henkjannl/BedClock/README.md

# BedClock
This is a small ESP driven bed clock annex reading light. The device can be controlled using three touch buttons.

<p align="center">
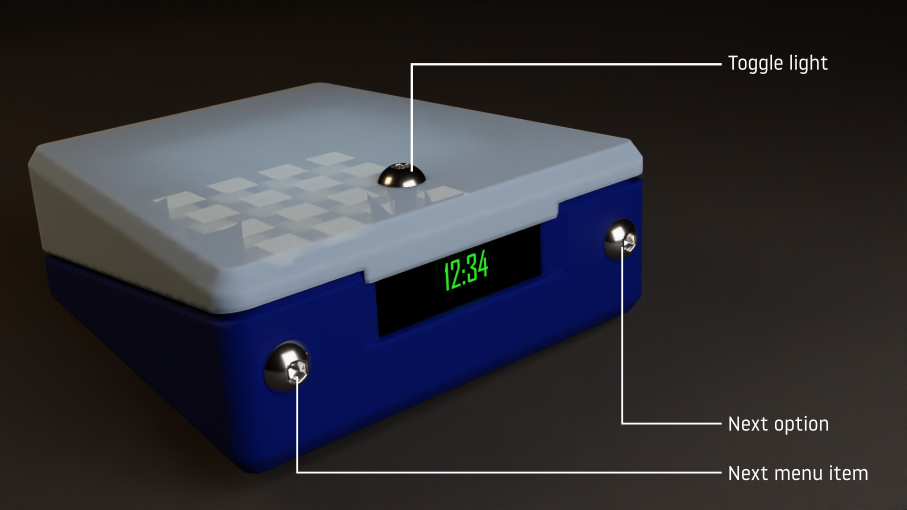
[picture p1: 02 User interface/Blender render/User manual.png]
    
</p>

The top button switches on and off the light on the top of the device. While the light is on, the clock is also shown (since darkness is polluted anyway).

By default the display is empty, because even at the dimmest intensity, the OLED display produces too much light to sleep well.

<p align="center">
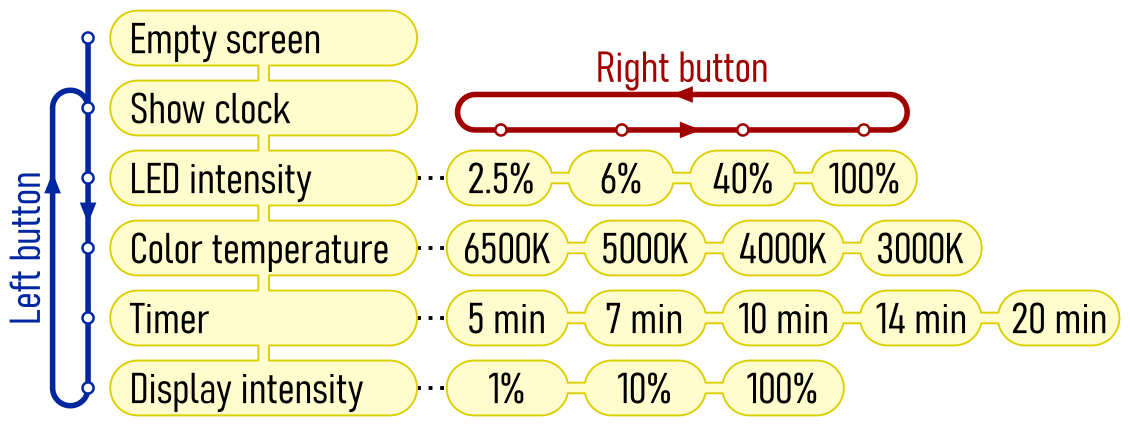
[picture p2: 02 User interface/ESP-IDF application/buttons.png]
    
</p>

The left button is used to wake up the display and browse through the settings. Each setting can be changed with the right button. While changing light settings, the light switches on to immediately show the result.

If the buttons are not touched  for some time, the display switches off again.

Settings are stored in the non volatile storage (NVS) of the ESP32.

## Hardware

This is a list of all items:

| Item | Count | Description | Print time | Price March 2023 |
|:----:|:-----:|---|---|---:|
| 1  | 1 | ESP32 MH-ET Live Minikit | | € 3.63 |
| 2  | 1 | 4x4 Led grid WS2812B | | € 1.00 |
| 3  | 1 | 0.91" OLED 128x32 SSD1306 | | € 1.53 |
| 4  | 1 | Electrical wire AWG 30 | | € 1.68 |
| 5  | 3 | Hexagon head button screw ISO7380-1 M3x8 | | € 1.45 |
| 6  | 3 | Hexagon nut ISO4032 M3 h=2.4 | | € 1.68 |
| 7  | 4 | Self tapping screw M2.3x12 | | € 2.33 |
| 8  | 2 | Self tapping screw M2.3x6 | | € 1.85 |
| 9  | 1 | Bottom part | 1h27 | € 0.50 |
|  10  | 1 | Top part (transparent filament) | 1h14 | € 0.42 |
|  11  | 1 | LED bridge | 0h34 | € 0.14 |
|  12  | 1 | Light cover | 0h05 | € 0.02 |
| | | **Total** | **3h20** | **€ 16.23** |

Items 1..8 were ordered at AliExpress through the following hyperlinks:

| Item | Count | Order |
|:----:|:-----:|---|
| 1  | 1 | https://www.aliexpress.com/item/32858054775.html |
| 2  | 1 | https://www.aliexpress.com/item/32963152993.html |
| 3  | 1 | https://www.aliexpress.com/item/32788923016.html |
| 4  | 1 | https://www.aliexpress.com/item/33030965448.html |
| 5  | 3 | https://www.aliexpress.com/item/32970195293.html |
| 6  | 3 | https://www.aliexpress.com/item/1005003780212966.html |
| 7  | 4 | https://www.aliexpress.com/item/1005003981975435.html |
| 8  | 2 | https://www.aliexpress.com/item/1005003981975435.html |

It can be beneficial to go for an assortment box of stainless steel screws if you have more similar products, like https://www.aliexpress.com/item/1005002526248698.html instead of items 5 and 6. Self tapping screws can also be ordered in assortment boxes.

Items 9..12 were 3D printed. Assumptions for print time and filament cost:
* Printer Prusa Mk3s
* Material PETG
* Layer height 0.2 mm

All devices are connected to the ESP32 by thin wires according to the schematic below:
<br>
<br>

<p align="center">
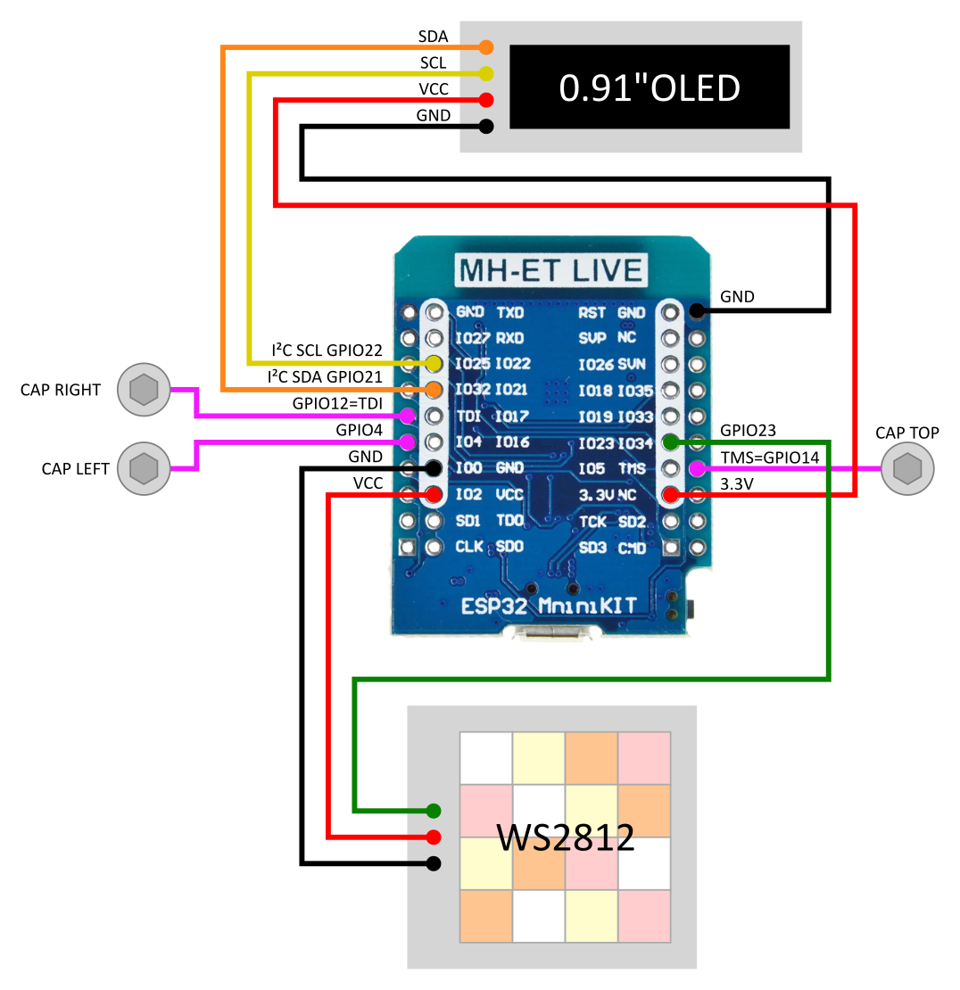
[picture p3: 05 Electrical/Electrical.png]
    
</p>

<br>
<br>

Mechanical assembly is as follows:

<p align="center">
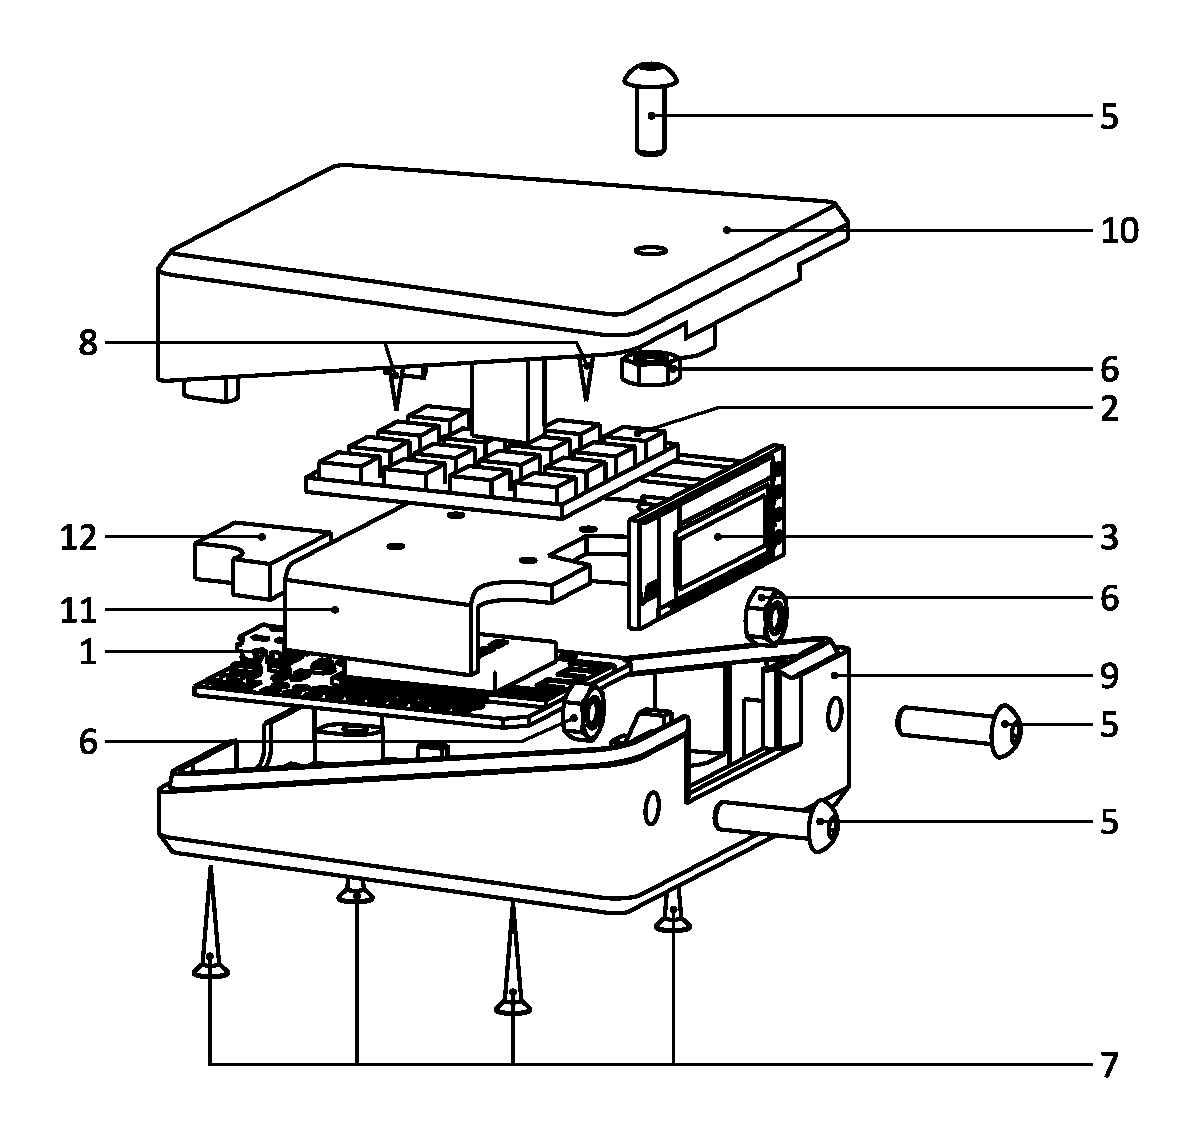
[picture p4: 03 Mechanical/Assembly manual/Assembly manual.png]
    
</p>

The 4x4 LED grid is mounted on top of the LED bridge and then placed over the ESP32.

The light cover 12 is used to cover the onboard LED of the ESP32, since it will shine through the top part if it is not covered.
<br>
<br>

## Software

The original Arduino based software is located in `...\BedClock\04_Software\Bedclock`.

This project was used to learn ESP-IDF programming under PlatformIO. The software projects `BedClock_IDF_V01` until `BedClock_IDF_V12` are demonstrator projects to port parts of the functionality to ESP-IDF.

### Different directories and sub-projects

| Directory | Purpose |
|---|---|
| `Bedclock_IDF_V01` | Test WS2812 led chain |
| `Bedclock_IDF_V02` | Test SSD1306 OLED screen |
| `Bedclock_IDF_V03` | Test capacitive touch sensors |
| `Bedclock_IDF_V04` | Test WiFi |
| `Bedclock_IDF_V05` | Test time sync with timeserver |
| `Bedclock_IDF_V06` | Port timer object using esp_timer_get_time() / 1000; |
| `Bedclock_IDF_V07` | Test FreeRTOS |
| `Bedclock_IDF_V08` | Implement multiple parallel processes |
| `Bedclock_IDF_V09` | Internal Espressif SSD1306 driver including LVGL |
| `Bedclock_IDF_V10` | First working version of application |
| `Bedclock_IDF_V11` | First working version of pixel buffer |
| `Bedclock_IDF_V12` | Latest version of the app with all functionality integrated |

### Files in the `Bedclock_IDF_V12` main directory

| File | Content |
|---|---|
| `main.c` | Main file, includes other files and calls initializers |
| `bl_common.h` | |
| `bl_keyboard.h` | Checks capacitive touch buttons and communicates with display and light |
| `bl_display.h` | Receives signals from keyboard, changes settings and writes current menu state to SSD1306 OLED display  |
| `bl_light.h` | Writes LED info for the LED grid to the rmt encoder |
| `led_strip_encoder.h+c` | Interface to the rmt encoder for the WS2812 LEDs |
| `bl_time.h` | Connection with WiFi, syncing of clock with timeserver |
| `config.h` | Private user data such as router name and password and timezone (not submitted to Github) |
| `hp_pixel_buffer.h+c` | Library that defines a bitmap for display on the OLED display |
| `hp_pixel_canvas.h+c` | Library that allows writing bitmaps to a buffer, and streaming the buffer to the SSD1306 OLED display |
| `fonts\...` | Font definitions |
| `hp_stepping_float.h` | Library that plans and executes paths in linear and non-linear ways (see also `hp_stepping_interpolation_t` below). |
| `hp_timer.h` | Library that defines a repeating or single-shot timer with microsecond resolution. |

The `config.h` file requires three `#defines`:
```c
#define WIFI_SSID    "xxxxxxxxx"                     // Name of the WiFi router
#define WIFI_PASS    "yyyyyyyy"                      // Password for the WiFi router
#define TIME_ZONE    "CET-1CEST,M3.5.0,M10.5.0/3"    // Timezone code
```

The last code is the timezone definition of Amsterdam. Codes for other locations can be found in https://github.com/nayarsystems/posix_tz_db/blob/master/zones.csv

In `hp_stepping_float.h`, the `hp_stepping_interpolation_t` type is an enumerator that defines the move path between origin and target in the following way:

<p align="center">
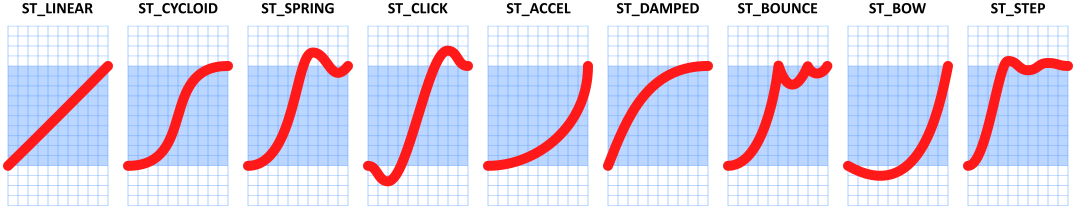
[picture p5: 01 System/Move profiles/Move.png]
    
</p>

### Issues

#### SSD1306
The OLED display sometimes freezes due to some unknown error. Since the hardware reset pin is not provided as GPIO for this display, only software reset is left as an option.

The clock frequency of I2C communication was reduced from 400kHz to 370kHz, since, according to the Salomon specification of the SSD1306, a frequency of up to 407kHz is tolerated, so there is not much headroom at 400kHz. This has not been an adequate solution. I'm not sure if 370kHz is actually working on the ESP32, or if it is rounded up to 400kHz as well.

As a fallback, pressing the left and right button at the same time resets the device. This is currently being tested.

See also:
https://iotexpert.com/debugging-ssd1306-display-problems/

Then the charge pump may be off
```c
    //////// Charge pump regulator
    OLED_CHARGEPUMP,          // 0x8D Set charge pump
    0x14,                     // VCC generated by internal DC/DC circuit
```
or maybe the screen is off… try turning it on.
```c
    OLED_DISPLAYON,           // 0xAF  //Set display on
```
or maybe you haven’t displayed anything. The screen is off trying sending a screen invert
```c
    #define OLED_DISPLAYINVERT                            0xA7
```

#### Filtering of capacitive touch buttons
The filtering of the capacitive touch buttons does not seem to work well, so I am using the unfiltered signal. Since there are sometimes 1 sample spikes on this signal, a button press is  only acknowledged if there are 3 subsequent samples below the threshold value.

If filtering works, it could also be a good idea to tie the capacitive touch buttons to an interrupt to relieve processor load.
