henkjannl/BedClock/04_Software/readme.md

### Readme
`Bedclock` is the software for the Arduino environment.

Different projects were created to port the Arduino version to ESP-IDF:
  * `Bedclock_IDF_V01` : Test WS2812 led chain
  * `Bedclock_IDF_V02` : Test SSD1306 OLED screen
  * `Bedclock_IDF_V03` : Test capacitive touch sensors
  * `Bedclock_IDF_V04` : Test WiFi
  * `Bedclock_IDF_V05` : Test time sync with timeserver
  * `Bedclock_IDF_V06` : Port timer object using esp_timer_get_time() / 1000;
  * `Bedclock_IDF_V07` : Test FreeRTOS
  * `Bedclock_IDF_V08` : Implement multiple parallel processes
  * `Bedclock_IDF_V09` : Internal Espressif SSD1306 driver including LVGL
  * `Bedclock_IDF_V10` : First working version of application
  * `Bedclock_IDF_V11` : First working version of pixel buffer
  * `Bedclock_IDF_V12` : First working version with graphics layout

`Bedclock_IDF_V12` is the version currently working.
