henkjannl/BedClock/01 System/Reorganize architecture (work in progress).ods

 |  |  | Row properties | Item properties:
 |  |  | Yoffset (32=hidden) | Label
 |  |  | Xoffset | Xoffset in row
 |  |  | Map of Items | Width
 |  |  | SelectedItem | Command when select is pressed
 |  |  |  | Command when next is pressed
 |  |  | Rows: | Items:
 |  |  | rwMain | itTimer, itBrightness, itColor, itGoBack
 |  |  | rwTimer | itTimer3min, itTimer5min, itTimer10min, itTimer20min
 |  |  | rwBrightness | itBrightness10, itBrightness20, itBrightness50, itBrightness100
 |  |  | rwColor | itColorWhite, itColorYellow, itColorOrange, itColorRed
 |  |  | General structure
 |  |  | Mode: | mdClock, mdSingleRow, mdDoubleRow
 |  |  | Map of rows
 |  |  | Top row
 |  |  | Bottom row
selected item | select button | next button
cmdClock | Display first row at bottom of screen Select cmdTimer | display first row at bottom of screen Timer selected
cmdTimer | Shift up screen to display second row Display timer options in second row Current interval selected | Select cmdBrightness
cmdBrightness | Shift up screen to display second row Display brightness options Current brightness selected | Select cmdColor
cmdColor | Shift up screen to display second row Display color options in second row Current option selected | Select cmdGoBack
cmdGoBack | Display clock | Select cmdTimer
cmdTimer3min | Set timer interval of 3 minutes Display first row at bottom of screen Select cmdTimer | Select cmdTimer5min
cmdTimer5min | Set timer interval of 5 minutes Display first row at bottom of screen Select cmdTimer | Select cmdTimer10min
cmdTimer10min | Set timer interval of 10 minutes Display first row at bottom of screen Select cmdTimer | Select cmdTimer20min
cmdTimer20min | Set timer interval of 20 minutes Display first row at bottom of screen Select cmdTimer | Select cmdTimer3min
