henkjannl/BedClock/04_Software/Bedclock_IDF_V03/readme.txt

### Readme
Bedclock_IDF_V01 demonstrates WS2812 LEDs
Bedclock_IDF_V02 demonstrates the display
Bedclock_IDF_V03 demonstrates capacitive touch buttons
Bedclock_IDF_V03 demonstrates  WiFi
