henkjannl/BedClock/04_Software/Bedclock_IDF_V01/readme.txt

### Readme
This project shows that the WS2812 LEDs are working
