henkjannl/BedClock/04_Software/Bedclock_IDF_V02/readme.txt

### Readme
Bedclock_IDF_V01 shows that the WS2812 LEDs are working
Bedclock_IDF_V02 shows the display is working
