henkjannl/BedClock/02 User interface/Blender render/Bedlight.png

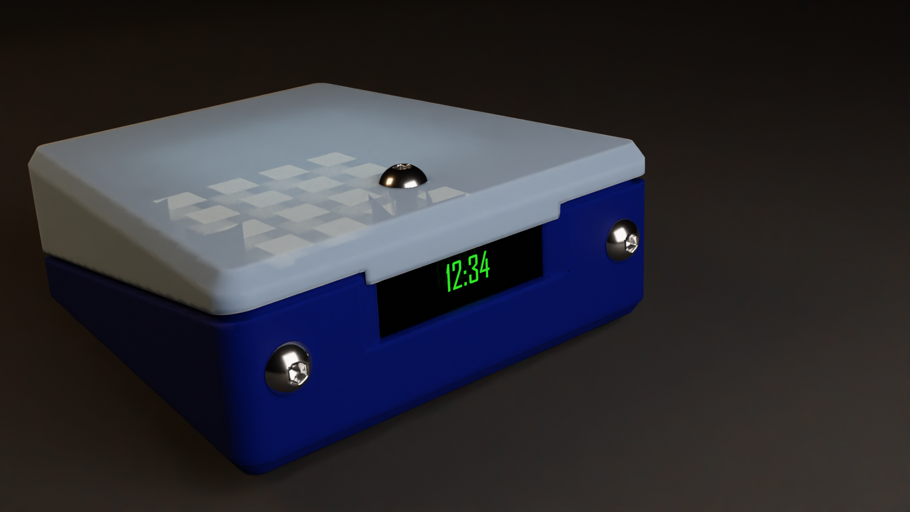
02 User interface/Blender render/Bedlight.png
