henkjannl/BedClock/02 User interface/Blender render/Telegram keyboard.png

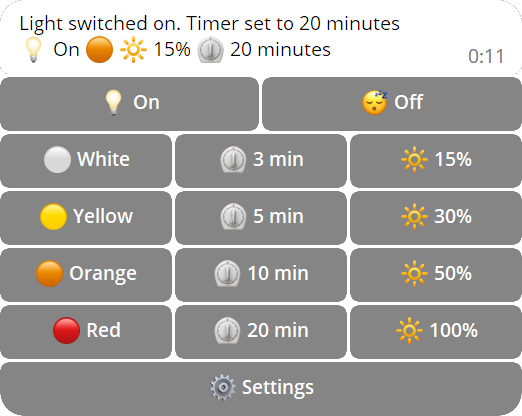
02 User interface/Blender render/Telegram keyboard.png
