henkjannl/BedClock/02 User interface/ESP-IDF application/128x32 GUI V5.png

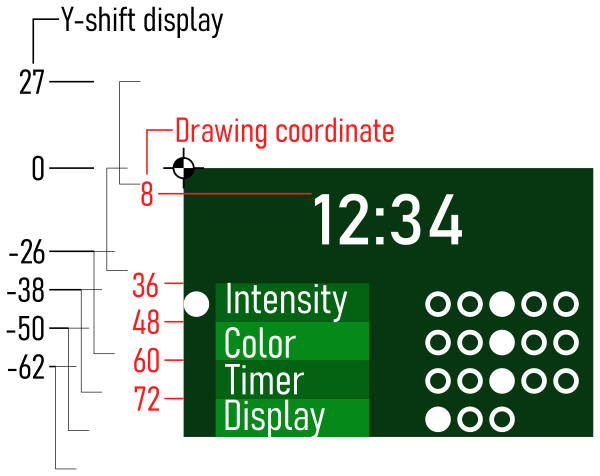
02 User interface/ESP-IDF application/128x32 GUI V5.png
