henkjannl/BedClock/02 User interface/HTML button tag_files/160x600_starterkit0.png

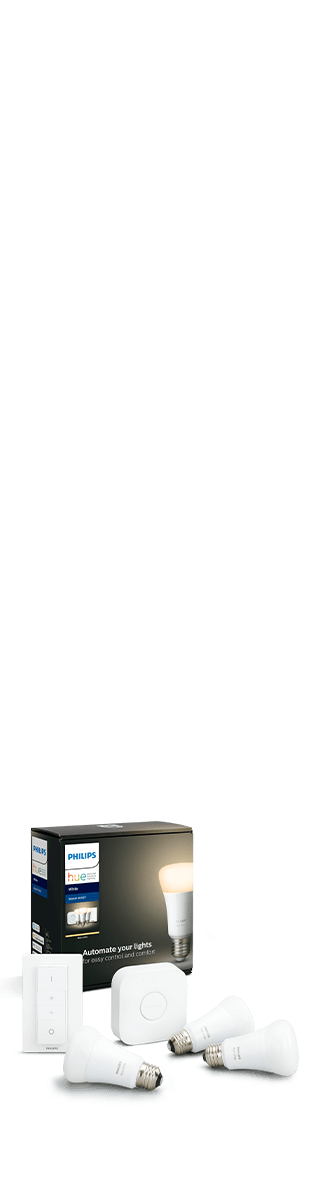
02 User interface/HTML button tag_files/160x600_starterkit0.png
