henkjannl/BedClock/02 User interface/HTML button tag_files/160x600_starterkit2.png

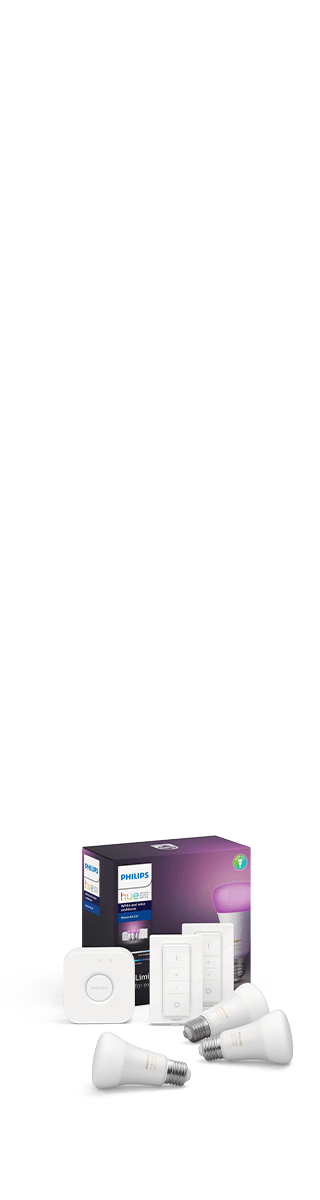
02 User interface/HTML button tag_files/160x600_starterkit2.png
