henkjannl/BedClock/02 User interface/HTML button tag_files/300x250_starterkit0.png

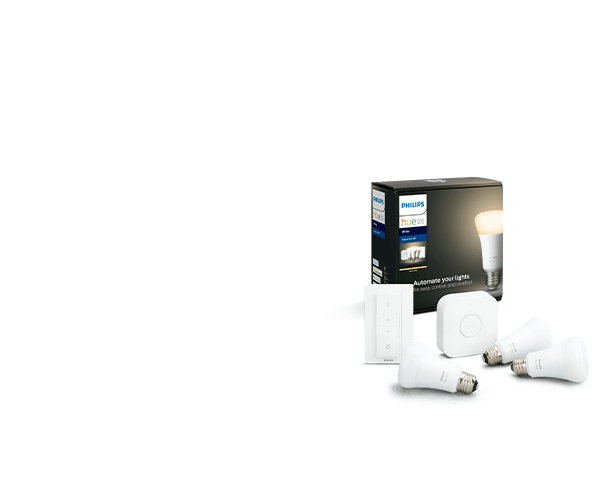
02 User interface/HTML button tag_files/300x250_starterkit0.png
