henkjannl/BedClock/02 User interface/HTML button tag_files/hue(1).png

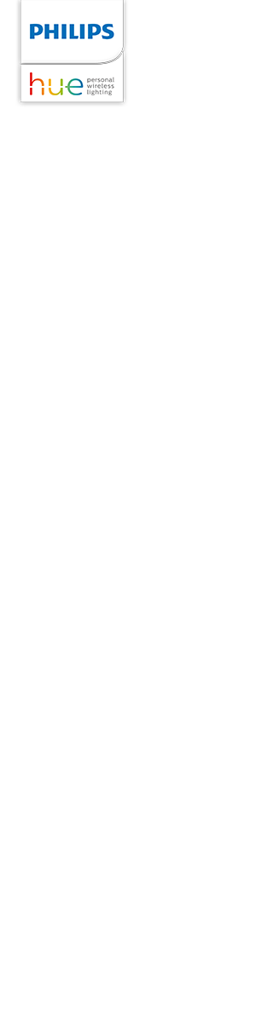
02 User interface/HTML button tag_files/hue(1).png
