henkjannl/BedClock/02 User interface/HTML button tag_files/hue.png

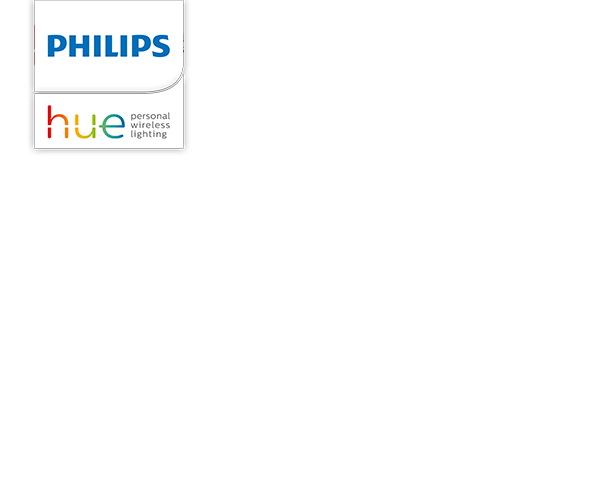
02 User interface/HTML button tag_files/hue.png
