henkjannl/BedClock/03 Mechanical/LEDs.stl

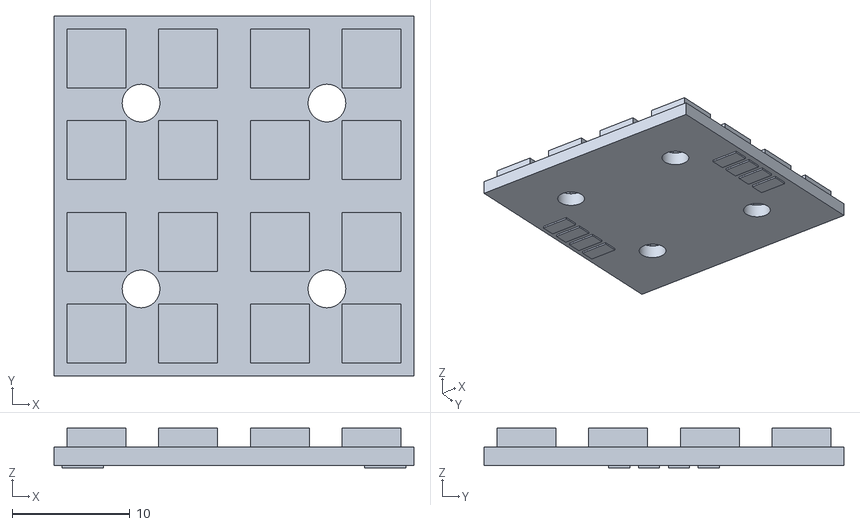
[picture p15: CAD file, 2023-03-12]
03 Mechanical/LEDs.stl
30.6 x 30.6 x 3.40
