henkjannl/BedClock/03 Mechanical/V2/Bridge.stl

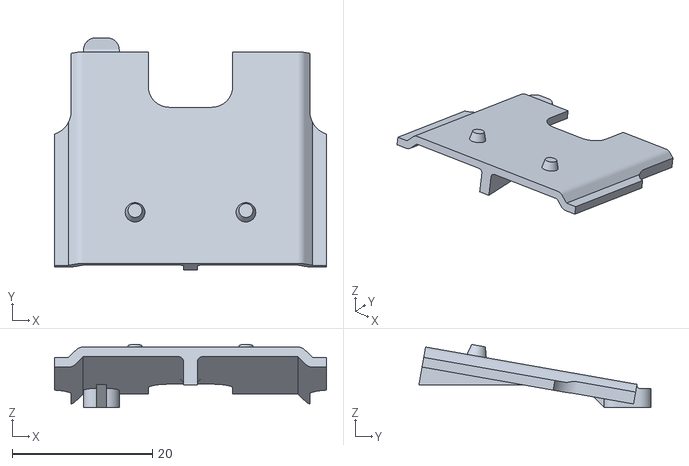
[picture p16: CAD file, 2023-03-17]
03 Mechanical/V2/Bridge.stl
38.8 x 33.1 x 9.00
