henkjannl/BedClock/03 Mechanical/Display 0.91'' 128x32 ST1306.FCStd

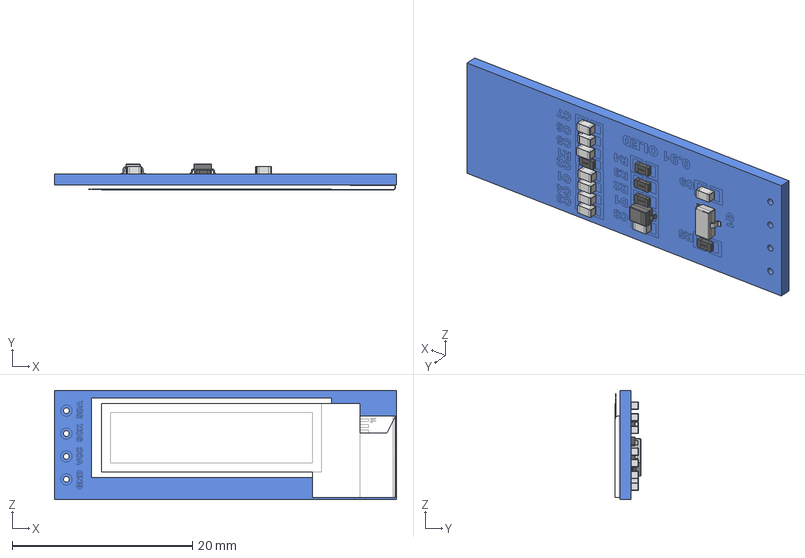
[picture p17: CAD file, 2023-03-12]
03 Mechanical/Display 0.91'' 128x32 ST1306.FCStd
37.9 x 2.93 x 12.1 mm
0.91in oled Module - Board
0.91in OLED - Folded Flush - Without Glass
0603 Capacitor
0603 Capacitor001
0603 Capacitor002
0603 Capacitor003
0603 Capacitor004
0603 Capacitor005
0603 Capacitor006
0603 Capacitor007
0603 Capacitor008
0603 Resistor
0603 Resistor001
0603 Resistor002
0603 Resistor003
0603 Resistor004
SOT23-3
Diode (SOD-323)
