henkjannl/BedClock/03 Mechanical/V2/Bottom housing V2.stl

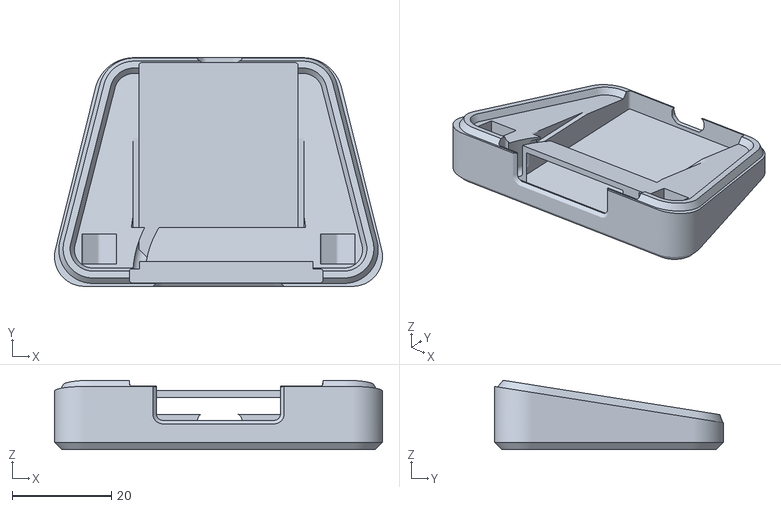
[picture p18: CAD file, 2023-03-12]
03 Mechanical/V2/Bottom housing V2.stl
66.0 x 46.0 x 14.0
