henkjannl/BedClock/03 Mechanical/Table.stl

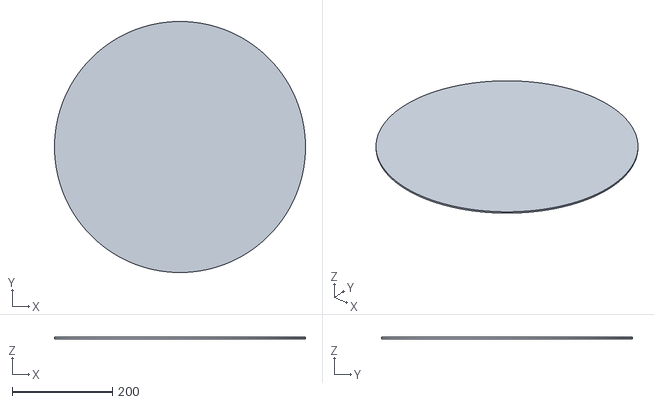
[picture p19: CAD file, 2023-03-12]
03 Mechanical/Table.stl
500.0 x 500.0 x 3.00
