henkjannl/BedClock/03 Mechanical/Bridge.stl

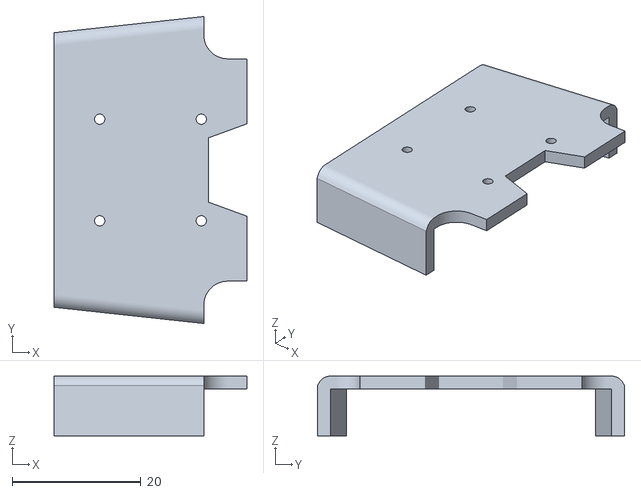
[picture p20: CAD file, 2023-03-12]
03 Mechanical/Bridge.stl
30.0 x 47.7 x 9.30
