henkjannl/BedClock/03 Mechanical/NightLight rotary.FCStd

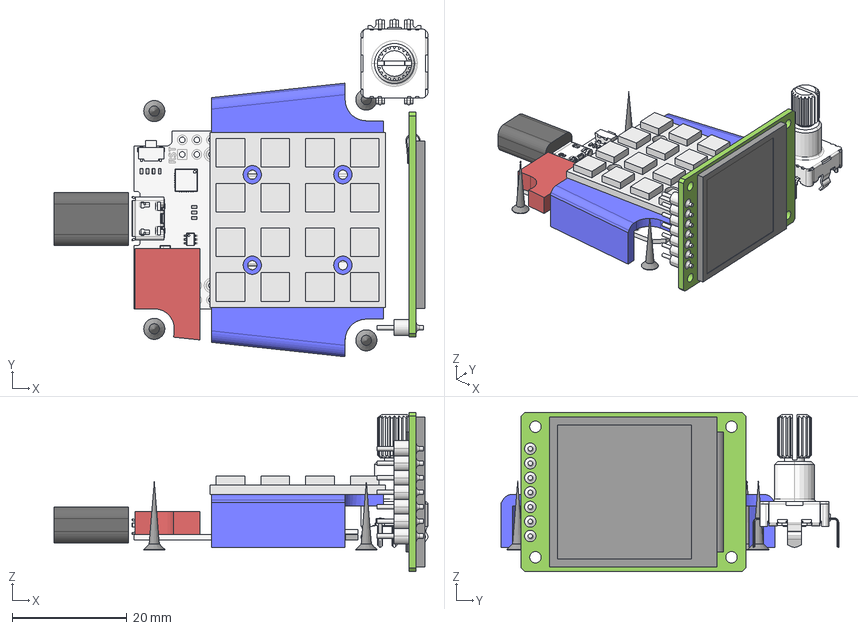
[picture p21: CAD file, 2023-01-20]
03 Mechanical/NightLight rotary.FCStd
65.3 x 58.9 x 27.8 mm
MH-ET_LIVE_MiniKit
USB connector
SelftappingScrew 2.3x12 - Bottom1
SelftappingScrew 2.3x12 - Bottom2
SelftappingScrew 2.3x12 - Bottom3
SelftappingScrew 2.3x12 - Bottom4
Bridge
LightCover
WS2812B 4x4_001
EC11E-05SW
SCREEN
GLASS
FIRSTPIN
