henkjannl/BedClock/03 Mechanical/Bottom.stl

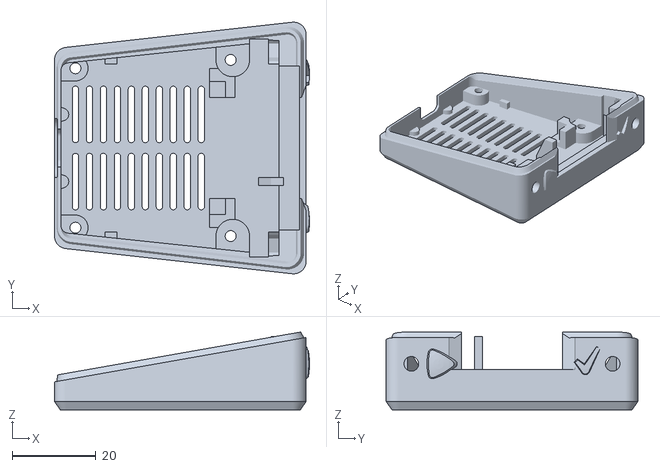
[picture p22: CAD file, 2021-05-28]
03 Mechanical/Bottom.stl
60.8 x 60.0 x 18.6
