henkjannl/BedClock/03 Mechanical/Top.stl

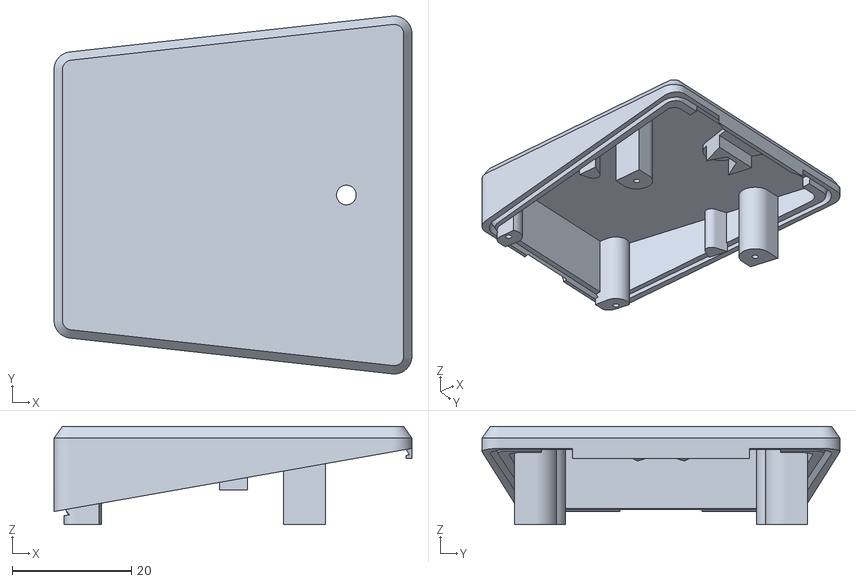
[picture p23: CAD file, 2021-04-11]
03 Mechanical/Top.stl
60.0 x 60.0 x 16.5
