henkjannl/BedClock/03 Mechanical/esp32-mh-et-live-minikit-d1.FCStd

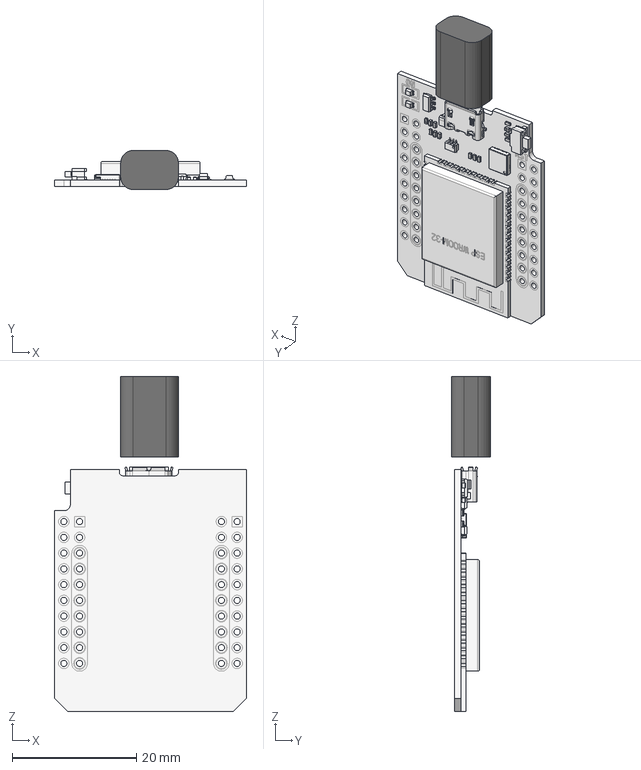
[picture p24: CAD file, 2021-04-11]
03 Mechanical/esp32-mh-et-live-minikit-d1.FCStd
31.0 x 6.30 x 54.0 mm
MH-ET_LIVE_MiniKit
