henkjannl/BedClock/03 Mechanical/Lightcover.stl

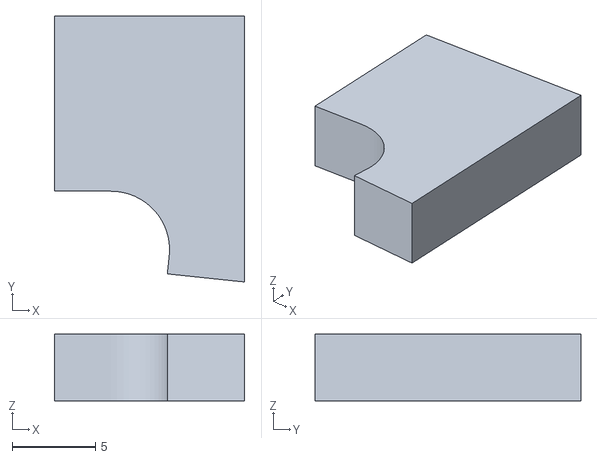
[picture p25: CAD file, 2021-04-11]
03 Mechanical/Lightcover.stl
11.4 x 15.9 x 4.00
