henkjannl/BedClock/03 Mechanical/SelftappingScrewM2.3x12.FCStd

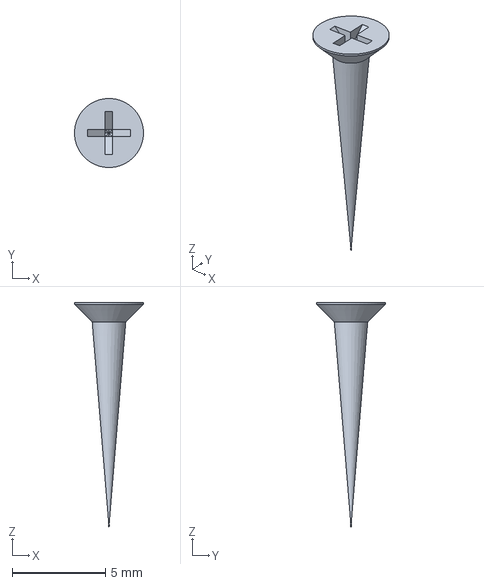
[picture p26: CAD file, 2021-04-11]
03 Mechanical/SelftappingScrewM2.3x12.FCStd
3.70 x 3.70 x 12.0 mm
