henkjannl/BedClock/(list of files, cad)

Other CAD files:
03 Mechanical/WS2812B 4x4.FCStd
