henkjannl/BedClock/04_Software/_Feasibility/03 DimSmooth/Brightness steps.xlsx

Order to switch on |  |  |  |  | Brightness substep | Additional LED | Decimal | Binary | Const
 | 0 | 1 | 2 | 3 | 0 |  | 0 | 0000000000000000 | 0x0000,
0 | 14 | 0 | 4 | 8 | 1 | 1 | 2 | 0000000000000010 | 0x0000, 0x0002,
4 | 7 | 11 | 13 | 1 | 2 | 7 | 130 | 0000000010000010 | 0x0000, 0x0002, 0x0082,
8 | 3 | 9 | 15 | 5 | 3 | 14 | 16514 | 0100000010000010 | 0x0000, 0x0002, 0x0082, 0x4082,
12 | 12 | 6 | 2 | 10 | 4 | 8 | 16770 | 0100000110000010 | 0x0000, 0x0002, 0x0082, 0x4082, 0x4182,
 |  |  |  |  | 5 | 2 | 16774 | 0100000110000110 | 0x0000, 0x0002, 0x0082, 0x4082, 0x4182, 0x4186,
 |  |  |  |  | 6 | 11 | 18822 | 0100100110000110 | 0x0000, 0x0002, 0x0082, 0x4082, 0x4182, 0x4186, 0x4986,
 |  |  |  |  | 7 | 13 | 27014 | 0110100110000110 | 0x0000, 0x0002, 0x0082, 0x4082, 0x4182, 0x4186, 0x4986, 0x6986,
 |  |  |  |  | 8 | 4 | 27030 | 0110100110010110 | 0x0000, 0x0002, 0x0082, 0x4082, 0x4182, 0x4186, 0x4986, 0x6986, 0x6996,
 |  |  |  |  | 9 | 3 | 27038 | 0110100110011110 | 0x0000, 0x0002, 0x0082, 0x4082, 0x4182, 0x4186, 0x4986, 0x6986, 0x6996, 0x699E,
 |  |  |  |  | 10 | 9 | 27550 | 0110101110011110 | 0x0000, 0x0002, 0x0082, 0x4082, 0x4182, 0x4186, 0x4986, 0x6986, 0x6996, 0x699E, 0x6B9E,
 |  |  |  |  | 11 | 15 | 60318 | 1110101110011110 | 0x0000, 0x0002, 0x0082, 0x4082, 0x4182, 0x4186, 0x4986, 0x6986, 0x6996, 0x699E, 0x6B9E, 0xEB9E,
 |  |  |  |  | 12 | 5 | 60350 | 1110101110111110 | 0x0000, 0x0002, 0x0082, 0x4082, 0x4182, 0x4186, 0x4986, 0x6986, 0x6996, 0x699E, 0x6B9E, 0xEB9E, 0xEBBE,
 |  |  |  |  | 13 | 12 | 64446 | 1111101110111110 | 0x0000, 0x0002, 0x0082, 0x4082, 0x4182, 0x4186, 0x4986, 0x6986, 0x6996, 0x699E, 0x6B9E, 0xEB9E, 0xEBBE, 0xFBBE,
 |  |  |  |  | 14 | 6 | 64510 | 1111101111111110 | 0x0000, 0x0002, 0x0082, 0x4082, 0x4182, 0x4186, 0x4986, 0x6986, 0x6996, 0x699E, 0x6B9E, 0xEB9E, 0xEBBE, 0xFBBE, 0xFBFE,
 |  |  |  |  | 15 | 0 | 64511 | 1111101111111111 | 0x0000, 0x0002, 0x0082, 0x4082, 0x4182, 0x4186, 0x4986, 0x6986, 0x6996, 0x699E, 0x6B9E, 0xEB9E, 0xEBBE, 0xFBBE, 0xFBFE, 0xFBFF,
The last LED will be switched on at the next major brightness step |  |  |  |  |  | 10 | 65535 | 1111111111111111
