henkjannl/BedClock/02 User interface/ESP-IDF application/user manual.png

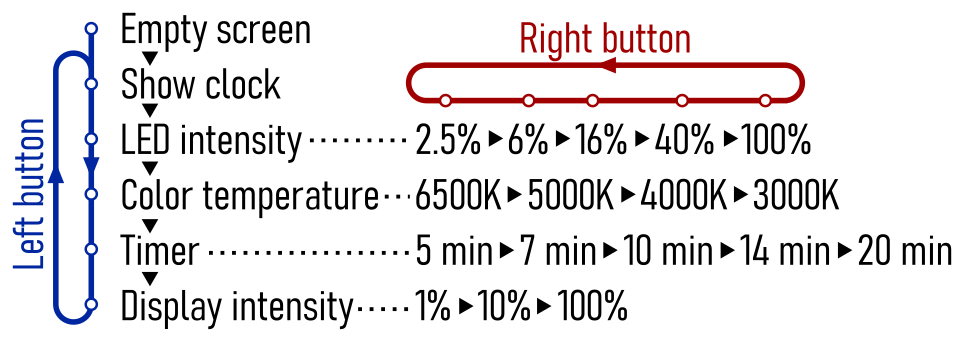
02 User interface/ESP-IDF application/user manual.png
