henkjannl/BedClock/01 System/Debounce capacitive sensors/Result from median kernel 3.txt

80	80
80	80
80	80
80	80
80	80
80	80
80	80
79	80
80	80
80	80
80	80
80	80
80	80
80	80
80	80
80	80
80	80
80	79
80	79
80	79
80	79
80	80
80	80
80	80
80	80
80	80
80	79
80	79
80	79
80	80
80	80
80	80
79	80
80	80
80	79
80	79
80	79
80	80
80	80
80	80
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
