henkjannl/BedClock/02 User interface/Arduino application/Full U8G2 font list/GetFontHeightAndWidth/GetFontHeightAndWidth.ino

#include <Wire.h>
#include <U8g2lib.h>

U8G2_SSD1306_128X32_UNIVISION_F_SW_I2C u8g2(U8G2_R2, 22, 21, U8X8_PIN_NONE);  

void setup() {
  Serial.begin(115200);
  u8g2.initDisplay();
  delay(500);
  u8g2.begin();
  TestAllFonts();
}

void loop() {
  // put your main code here, to run repeatedly:

}


struct font_t {
  char fontName[50];
  const uint8_t *font;
};

const font_t TF_FONTS[] = {
/*     
  { "u8g2_font_u8glib_4_tf", u8g2_font_u8glib_4_tf },
  { "u8g2_font_m2icon_5_tf", u8g2_font_m2icon_5_tf },
  { "u8g2_font_m2icon_7_tf", u8g2_font_m2icon_7_tf },
  { "u8g2_font_m2icon_9_tf", u8g2_font_m2icon_9_tf },
  { "u8g2_font_cursor_tf", u8g2_font_cursor_tf },    
  { "u8g2_font_4x6_tf", u8g2_font_4x6_tf },
  { "u8g2_font_5x7_tf", u8g2_font_5x7_tf },
  { "u8g2_font_5x8_tf", u8g2_font_5x8_tf },
  { "u8g2_font_6x10_tf", u8g2_font_6x10_tf },
  { "u8g2_font_6x12_tf", u8g2_font_6x12_tf },
  { "u8g2_font_6x13_tf", u8g2_font_6x13_tf },
  { "u8g2_font_6x13B_tf", u8g2_font_6x13B_tf },
  { "u8g2_font_6x13O_tf", u8g2_font_6x13O_tf },
  { "u8g2_font_7x13_tf", u8g2_font_7x13_tf },
  { "u8g2_font_7x13B_tf", u8g2_font_7x13B_tf },
  { "u8g2_font_7x13O_tf", u8g2_font_7x13O_tf },
  { "u8g2_font_7x14_tf", u8g2_font_7x14_tf },
  { "u8g2_font_7x14B_tf", u8g2_font_7x14B_tf },
  { "u8g2_font_8x13_tf", u8g2_font_8x13_tf },
  { "u8g2_font_8x13B_tf", u8g2_font_8x13B_tf },
  { "u8g2_font_8x13O_tf", u8g2_font_8x13O_tf },
  { "u8g2_font_9x15_tf", u8g2_font_9x15_tf },
  { "u8g2_font_9x15B_tf", u8g2_font_9x15B_tf },
  { "u8g2_font_9x18_tf", u8g2_font_9x18_tf },
  { "u8g2_font_9x18B_tf", u8g2_font_9x18B_tf },
  { "u8g2_font_10x20_tf", u8g2_font_10x20_tf },
  { "u8g2_font_tom_thumb_4x6_tf", u8g2_font_tom_thumb_4x6_tf },
  { "u8g2_font_mystery_quest_24_tf", u8g2_font_mystery_quest_24_tf },
  { "u8g2_font_mystery_quest_28_tf", u8g2_font_mystery_quest_28_tf },
  { "u8g2_font_t0_11_tf", u8g2_font_t0_11_tf },
  { "u8g2_font_t0_11b_tf", u8g2_font_t0_11b_tf },
  { "u8g2_font_t0_12_tf", u8g2_font_t0_12_tf },
  { "u8g2_font_t0_12b_tf", u8g2_font_t0_12b_tf },
  { "u8g2_font_t0_13_tf", u8g2_font_t0_13_tf },
  { "u8g2_font_t0_13b_tf", u8g2_font_t0_13b_tf },
  { "u8g2_font_t0_14_tf", u8g2_font_t0_14_tf },
  { "u8g2_font_t0_14b_tf", u8g2_font_t0_14b_tf },
  { "u8g2_font_t0_15_tf", u8g2_font_t0_15_tf },
  { "u8g2_font_t0_15b_tf", u8g2_font_t0_15b_tf },
  { "u8g2_font_t0_16_tf", u8g2_font_t0_16_tf },
  { "u8g2_font_t0_16b_tf", u8g2_font_t0_16b_tf },
  { "u8g2_font_t0_17_tf", u8g2_font_t0_17_tf },
  { "u8g2_font_t0_17b_tf", u8g2_font_t0_17b_tf },
  { "u8g2_font_t0_18_tf", u8g2_font_t0_18_tf },
  { "u8g2_font_t0_18b_tf", u8g2_font_t0_18b_tf },
  { "u8g2_font_t0_22_tf", u8g2_font_t0_22_tf },
  { "u8g2_font_t0_22b_tf", u8g2_font_t0_22b_tf },
  { "u8g2_font_profont10_tf", u8g2_font_profont10_tf },
  { "u8g2_font_profont11_tf", u8g2_font_profont11_tf },
  { "u8g2_font_profont12_tf", u8g2_font_profont12_tf },
  { "u8g2_font_profont15_tf", u8g2_font_profont15_tf },
  { "u8g2_font_profont17_tf", u8g2_font_profont17_tf },
  { "u8g2_font_profont22_tf", u8g2_font_profont22_tf },
  { "u8g2_font_profont29_tf", u8g2_font_profont29_tf },
  { "u8g2_font_mozart_nbp_tf", u8g2_font_mozart_nbp_tf },
  { "u8g2_font_glasstown_nbp_tf", u8g2_font_glasstown_nbp_tf },
  { "u8g2_font_shylock_nbp_tf", u8g2_font_shylock_nbp_tf },
  { "u8g2_font_roentgen_nbp_tf", u8g2_font_roentgen_nbp_tf },
  { "u8g2_font_calibration_gothic_nbp_tf", u8g2_font_calibration_gothic_nbp_tf },
  { "u8g2_font_smart_patrol_nbp_tf", u8g2_font_smart_patrol_nbp_tf },
  { "u8g2_font_prospero_bold_nbp_tf", u8g2_font_prospero_bold_nbp_tf },
  { "u8g2_font_prospero_nbp_tf", u8g2_font_prospero_nbp_tf },
  { "u8g2_font_balthasar_regular_nbp_tf", u8g2_font_balthasar_regular_nbp_tf },
  { "u8g2_font_balthasar_titling_nbp_tf", u8g2_font_balthasar_titling_nbp_tf },
  { "u8g2_font_synchronizer_nbp_tf", u8g2_font_synchronizer_nbp_tf },
  { "u8g2_font_mercutio_basic_nbp_tf", u8g2_font_mercutio_basic_nbp_tf },
  { "u8g2_font_mercutio_sc_nbp_tf", u8g2_font_mercutio_sc_nbp_tf },
  { "u8g2_font_miranda_nbp_tf", u8g2_font_miranda_nbp_tf },
  { "u8g2_font_nine_by_five_nbp_tf", u8g2_font_nine_by_five_nbp_tf },
  { "u8g2_font_rosencrantz_nbp_tf", u8g2_font_rosencrantz_nbp_tf },
  { "u8g2_font_guildenstern_nbp_tf", u8g2_font_guildenstern_nbp_tf },
  { "u8g2_font_astragal_nbp_tf", u8g2_font_astragal_nbp_tf },
  { "u8g2_font_habsburgchancery_tf", u8g2_font_habsburgchancery_tf },
  { "u8g2_font_missingplanet_tf", u8g2_font_missingplanet_tf },
  { "u8g2_font_ordinarybasis_tf", u8g2_font_ordinarybasis_tf },
  { "u8g2_font_pixelmordred_tf", u8g2_font_pixelmordred_tf },
  { "u8g2_font_secretaryhand_tf", u8g2_font_secretaryhand_tf },
  { "u8g2_font_garbagecan_tf", u8g2_font_garbagecan_tf },
  { "u8g2_font_oldwizard_tf", u8g2_font_oldwizard_tf },
  { "u8g2_font_bitcasual_tf", u8g2_font_bitcasual_tf },
  { "u8g2_font_koleeko_tf", u8g2_font_koleeko_tf },
  { "u8g2_font_tenfatguys_tf", u8g2_font_tenfatguys_tf },
  { "u8g2_font_tenthinguys_tf", u8g2_font_tenthinguys_tf },
  { "u8g2_font_tenthinnerguys_tf", u8g2_font_tenthinnerguys_tf },
  { "u8g2_font_fewture_tf", u8g2_font_fewture_tf },
  { "u8g2_font_halftone_tf", u8g2_font_halftone_tf },
  { "u8g2_font_nerhoe_tf", u8g2_font_nerhoe_tf },
  { "u8g2_font_oskool_tf", u8g2_font_oskool_tf },
  { "u8g2_font_tinytim_tf", u8g2_font_tinytim_tf },
  { "u8g2_font_tooseornament_tf", u8g2_font_tooseornament_tf },
  { "u8g2_font_finderskeepers_tf", u8g2_font_finderskeepers_tf },
  { "u8g2_font_adventurer_tf", u8g2_font_adventurer_tf },
  { "u8g2_font_frikativ_tf", u8g2_font_frikativ_tf },
  { "u8g2_font_fancypixels_tf", u8g2_font_fancypixels_tf },
  { "u8g2_font_fourmat_tf", u8g2_font_fourmat_tf },
  { "u8g2_font_smolfont_tf", u8g2_font_smolfont_tf },
  { "u8g2_font_tinyunicode_tf", u8g2_font_tinyunicode_tf },
  { "u8g2_font_micropixel_tf", u8g2_font_micropixel_tf },
  { "u8g2_font_simple1_tf", u8g2_font_simple1_tf },
  { "u8g2_font_scrum_tf", u8g2_font_scrum_tf },
  { "u8g2_font_8bitclassic_tf", u8g2_font_8bitclassic_tf },
  { "u8g2_font_new3x9pixelfont_tf", u8g2_font_new3x9pixelfont_tf },
  { "u8g2_font_bytesize_tf", u8g2_font_bytesize_tf },
  { "u8g2_font_pixzillav1_tf", u8g2_font_pixzillav1_tf },
  { "u8g2_font_pxclassic_tf", u8g2_font_pxclassic_tf },
  { "u8g2_font_tallpixelextended_tf", u8g2_font_tallpixelextended_tf },
  { "u8g2_font_BBSesque_tf", u8g2_font_BBSesque_tf },
  { "u8g2_font_Born2bSportySlab_tf", u8g2_font_Born2bSportySlab_tf },
  { "u8g2_font_Born2bSportyV2_tf", u8g2_font_Born2bSportyV2_tf },
  { "u8g2_font_Engrish_tf", u8g2_font_Engrish_tf },
  { "u8g2_font_IPAandRUSLCD_tf", u8g2_font_IPAandRUSLCD_tf },
  { "u8g2_font_Georgia7px_tf", u8g2_font_Georgia7px_tf },
  { "u8g2_font_NokiaLargeBold_tf", u8g2_font_NokiaLargeBold_tf },
  { "u8g2_font_NokiaSmallBold_tf", u8g2_font_NokiaSmallBold_tf },
  { "u8g2_font_NokiaSmallPlain_tf", u8g2_font_NokiaSmallPlain_tf },
  { "u8g2_font_12x6LED_tf", u8g2_font_12x6LED_tf },
  { "u8g2_font_9x6LED_tf", u8g2_font_9x6LED_tf },
  { "u8g2_font_nokiafc22_tf", u8g2_font_nokiafc22_tf },
  { "u8g2_font_VCR_OSD_tf", u8g2_font_VCR_OSD_tf },
  { "u8g2_font_Pixellari_tf", u8g2_font_Pixellari_tf },
  { "u8g2_font_DigitalDiscoThin_tf", u8g2_font_DigitalDiscoThin_tf },
  { "u8g2_font_DigitalDisco_tf", u8g2_font_DigitalDisco_tf },
  { "u8g2_font_crox1cb_tf", u8g2_font_crox1cb_tf },
  { "u8g2_font_crox1c_tf", u8g2_font_crox1c_tf },
  { "u8g2_font_crox1hb_tf", u8g2_font_crox1hb_tf },
  { "u8g2_font_crox1h_tf", u8g2_font_crox1h_tf },
  { "u8g2_font_crox1tb_tf", u8g2_font_crox1tb_tf },
  { "u8g2_font_crox1t_tf", u8g2_font_crox1t_tf },
  { "u8g2_font_crox2cb_tf", u8g2_font_crox2cb_tf },
  { "u8g2_font_crox2c_tf", u8g2_font_crox2c_tf },
  { "u8g2_font_crox2hb_tf", u8g2_font_crox2hb_tf },
  { "u8g2_font_crox2h_tf", u8g2_font_crox2h_tf },
  { "u8g2_font_crox2tb_tf", u8g2_font_crox2tb_tf },
  { "u8g2_font_crox2t_tf", u8g2_font_crox2t_tf },
  { "u8g2_font_crox3cb_tf", u8g2_font_crox3cb_tf },
  { "u8g2_font_crox3c_tf", u8g2_font_crox3c_tf },
  { "u8g2_font_crox3hb_tf", u8g2_font_crox3hb_tf },
  { "u8g2_font_crox3h_tf", u8g2_font_crox3h_tf },
  { "u8g2_font_crox3tb_tf", u8g2_font_crox3tb_tf },
  { "u8g2_font_crox3t_tf", u8g2_font_crox3t_tf },
  { "u8g2_font_crox4hb_tf", u8g2_font_crox4hb_tf },
  { "u8g2_font_crox4h_tf", u8g2_font_crox4h_tf },
  { "u8g2_font_crox4tb_tf", u8g2_font_crox4tb_tf },
  { "u8g2_font_crox4t_tf", u8g2_font_crox4t_tf },
  { "u8g2_font_crox5hb_tf", u8g2_font_crox5hb_tf },
  { "u8g2_font_crox5h_tf", u8g2_font_crox5h_tf },
  { "u8g2_font_crox5tb_tf", u8g2_font_crox5tb_tf },
  { "u8g2_font_crox5t_tf", u8g2_font_crox5t_tf },
  { "u8g2_font_cu12_tf", u8g2_font_cu12_tf },
  { "u8g2_font_unifont_tf", u8g2_font_unifont_tf },
  { "u8g2_font_courB08_tf", u8g2_font_courB08_tf },
  { "u8g2_font_courB10_tf", u8g2_font_courB10_tf },
  { "u8g2_font_courB12_tf", u8g2_font_courB12_tf },
  { "u8g2_font_courB14_tf", u8g2_font_courB14_tf },
  { "u8g2_font_courB18_tf", u8g2_font_courB18_tf },
  { "u8g2_font_courB24_tf", u8g2_font_courB24_tf },
  { "u8g2_font_courR08_tf", u8g2_font_courR08_tf },
  { "u8g2_font_courR10_tf", u8g2_font_courR10_tf },
  { "u8g2_font_courR12_tf", u8g2_font_courR12_tf },
  { "u8g2_font_courR14_tf", u8g2_font_courR14_tf },
  { "u8g2_font_courR18_tf", u8g2_font_courR18_tf },
  { "u8g2_font_courR24_tf", u8g2_font_courR24_tf },
  { "u8g2_font_helvB08_tf", u8g2_font_helvB08_tf },
  { "u8g2_font_helvB10_tf", u8g2_font_helvB10_tf },
  { "u8g2_font_helvB12_tf", u8g2_font_helvB12_tf },
  { "u8g2_font_helvB14_tf", u8g2_font_helvB14_tf },
  { "u8g2_font_helvB18_tf", u8g2_font_helvB18_tf },
  { "u8g2_font_helvB24_tf", u8g2_font_helvB24_tf },
  { "u8g2_font_helvR08_tf", u8g2_font_helvR08_tf },
  { "u8g2_font_helvR10_tf", u8g2_font_helvR10_tf },
  { "u8g2_font_helvR12_tf", u8g2_font_helvR12_tf },
  { "u8g2_font_helvR14_tf", u8g2_font_helvR14_tf },
  { "u8g2_font_helvR18_tf", u8g2_font_helvR18_tf },
  { "u8g2_font_helvR24_tf", u8g2_font_helvR24_tf },
  { "u8g2_font_ncenB08_tf", u8g2_font_ncenB08_tf },
  { "u8g2_font_ncenB10_tf", u8g2_font_ncenB10_tf },
  { "u8g2_font_ncenB12_tf", u8g2_font_ncenB12_tf },
  { "u8g2_font_ncenB14_tf", u8g2_font_ncenB14_tf },
  { "u8g2_font_ncenB18_tf", u8g2_font_ncenB18_tf },
  { "u8g2_font_ncenB24_tf", u8g2_font_ncenB24_tf },
  { "u8g2_font_ncenR08_tf", u8g2_font_ncenR08_tf },
  { "u8g2_font_ncenR10_tf", u8g2_font_ncenR10_tf },
  { "u8g2_font_ncenR12_tf", u8g2_font_ncenR12_tf },
  { "u8g2_font_ncenR14_tf", u8g2_font_ncenR14_tf },
  { "u8g2_font_ncenR18_tf", u8g2_font_ncenR18_tf },
  { "u8g2_font_ncenR24_tf", u8g2_font_ncenR24_tf },
  { "u8g2_font_timB08_tf", u8g2_font_timB08_tf },
  { "u8g2_font_timB10_tf", u8g2_font_timB10_tf },
  { "u8g2_font_timB12_tf", u8g2_font_timB12_tf },
  { "u8g2_font_timB14_tf", u8g2_font_timB14_tf },
  { "u8g2_font_timB18_tf", u8g2_font_timB18_tf },
  { "u8g2_font_timB24_tf", u8g2_font_timB24_tf },
  { "u8g2_font_timR08_tf", u8g2_font_timR08_tf },
  { "u8g2_font_timR10_tf", u8g2_font_timR10_tf },
  { "u8g2_font_timR12_tf", u8g2_font_timR12_tf },
  { "u8g2_font_timR14_tf", u8g2_font_timR14_tf },
  { "u8g2_font_timR18_tf", u8g2_font_timR18_tf },
  { "u8g2_font_timR24_tf", u8g2_font_timR24_tf },
  { "u8g2_font_lubB08_tf", u8g2_font_lubB08_tf },
  { "u8g2_font_lubB10_tf", u8g2_font_lubB10_tf },
  { "u8g2_font_lubB12_tf", u8g2_font_lubB12_tf },
  { "u8g2_font_lubB14_tf", u8g2_font_lubB14_tf },
  { "u8g2_font_lubB18_tf", u8g2_font_lubB18_tf },
  { "u8g2_font_lubB19_tf", u8g2_font_lubB19_tf },
  { "u8g2_font_lubB24_tf", u8g2_font_lubB24_tf },
  { "u8g2_font_lubBI08_tf", u8g2_font_lubBI08_tf },
  { "u8g2_font_lubBI10_tf", u8g2_font_lubBI10_tf },
  { "u8g2_font_lubBI12_tf", u8g2_font_lubBI12_tf },
  { "u8g2_font_lubBI14_tf", u8g2_font_lubBI14_tf },
  { "u8g2_font_lubBI18_tf", u8g2_font_lubBI18_tf },
  { "u8g2_font_lubBI19_tf", u8g2_font_lubBI19_tf },
  { "u8g2_font_lubBI24_tf", u8g2_font_lubBI24_tf },
  { "u8g2_font_lubI08_tf", u8g2_font_lubI08_tf },
  { "u8g2_font_lubI10_tf", u8g2_font_lubI10_tf },
  { "u8g2_font_lubI12_tf", u8g2_font_lubI12_tf },
  { "u8g2_font_lubI14_tf", u8g2_font_lubI14_tf },
  { "u8g2_font_lubI18_tf", u8g2_font_lubI18_tf },
  { "u8g2_font_lubI19_tf", u8g2_font_lubI19_tf },
  { "u8g2_font_lubI24_tf", u8g2_font_lubI24_tf },
  { "u8g2_font_luBIS08_tf", u8g2_font_luBIS08_tf },
  { "u8g2_font_luBIS10_tf", u8g2_font_luBIS10_tf },
  { "u8g2_font_luBIS12_tf", u8g2_font_luBIS12_tf },
  { "u8g2_font_luBIS14_tf", u8g2_font_luBIS14_tf },
  { "u8g2_font_luBIS18_tf", u8g2_font_luBIS18_tf },
  { "u8g2_font_luBIS19_tf", u8g2_font_luBIS19_tf },
  { "u8g2_font_luBIS24_tf", u8g2_font_luBIS24_tf },
  { "u8g2_font_lubR08_tf", u8g2_font_lubR08_tf },
  { "u8g2_font_lubR10_tf", u8g2_font_lubR10_tf },
  { "u8g2_font_lubR12_tf", u8g2_font_lubR12_tf },
  { "u8g2_font_lubR14_tf", u8g2_font_lubR14_tf },
  { "u8g2_font_lubR18_tf", u8g2_font_lubR18_tf },
  { "u8g2_font_lubR19_tf", u8g2_font_lubR19_tf },
  { "u8g2_font_lubR24_tf", u8g2_font_lubR24_tf },
  { "u8g2_font_luBS08_tf", u8g2_font_luBS08_tf },
  { "u8g2_font_luBS10_tf", u8g2_font_luBS10_tf },
  { "u8g2_font_luBS12_tf", u8g2_font_luBS12_tf },
  { "u8g2_font_luBS14_tf", u8g2_font_luBS14_tf },
  { "u8g2_font_luBS18_tf", u8g2_font_luBS18_tf },
  { "u8g2_font_luBS19_tf", u8g2_font_luBS19_tf },
  { "u8g2_font_luBS24_tf", u8g2_font_luBS24_tf },
  { "u8g2_font_luIS08_tf", u8g2_font_luIS08_tf },
  { "u8g2_font_luIS10_tf", u8g2_font_luIS10_tf },
  { "u8g2_font_luIS12_tf", u8g2_font_luIS12_tf },
  { "u8g2_font_luIS14_tf", u8g2_font_luIS14_tf },
  { "u8g2_font_luIS18_tf", u8g2_font_luIS18_tf },
  { "u8g2_font_luIS19_tf", u8g2_font_luIS19_tf },
  { "u8g2_font_luIS24_tf", u8g2_font_luIS24_tf },
  { "u8g2_font_luRS08_tf", u8g2_font_luRS08_tf },
  { "u8g2_font_luRS10_tf", u8g2_font_luRS10_tf },
  { "u8g2_font_luRS12_tf", u8g2_font_luRS12_tf },
  { "u8g2_font_luRS14_tf", u8g2_font_luRS14_tf },
  { "u8g2_font_luRS18_tf", u8g2_font_luRS18_tf },
  { "u8g2_font_luRS19_tf", u8g2_font_luRS19_tf },
  { "u8g2_font_luRS24_tf", u8g2_font_luRS24_tf },
  { "u8g2_font_baby_tf", u8g2_font_baby_tf },
  { "u8g2_font_chikita_tf", u8g2_font_chikita_tf },
  { "u8g2_font_lucasfont_alternate_tf", u8g2_font_lucasfont_alternate_tf },
  { "u8g2_font_p01type_tf", u8g2_font_p01type_tf },
  { "u8g2_font_robot_de_niro_tf", u8g2_font_robot_de_niro_tf },
  { "u8g2_font_trixel_square_tf", u8g2_font_trixel_square_tf },
  { "u8g2_font_cardimon_pixel_tf", u8g2_font_cardimon_pixel_tf },
  { "u8g2_font_maniac_tf", u8g2_font_maniac_tf },
  { "u8g2_font_lucasarts_scumm_subtitle_o_tf", u8g2_font_lucasarts_scumm_subtitle_o_tf },
  { "u8g2_font_lucasarts_scumm_subtitle_r_tf", u8g2_font_lucasarts_scumm_subtitle_r_tf },
  { "u8g2_font_utopia24_tf", u8g2_font_utopia24_tf },
  { "u8g2_font_chargen_92_tf", u8g2_font_chargen_92_tf },
  { "u8g2_font_fub11_tf", u8g2_font_fub11_tf },
  { "u8g2_font_fub14_tf", u8g2_font_fub14_tf },
  { "u8g2_font_fub17_tf", u8g2_font_fub17_tf },
  { "u8g2_font_fub20_tf", u8g2_font_fub20_tf },
  { "u8g2_font_fub25_tf", u8g2_font_fub25_tf },
  { "u8g2_font_fub30_tf", u8g2_font_fub30_tf },
*/  
  { "u8g2_font_fub35_tf", u8g2_font_fub35_tf },
  { "u8g2_font_fub42_tf", u8g2_font_fub42_tf },
  { "u8g2_font_fur11_tf", u8g2_font_fur11_tf },
  { "u8g2_font_fur14_tf", u8g2_font_fur14_tf },
  { "u8g2_font_fur17_tf", u8g2_font_fur17_tf },
  { "u8g2_font_fur20_tf", u8g2_font_fur20_tf },
  { "u8g2_font_fur25_tf", u8g2_font_fur25_tf },
  { "u8g2_font_fur30_tf", u8g2_font_fur30_tf },
  { "u8g2_font_fur35_tf", u8g2_font_fur35_tf },
  { "u8g2_font_fur42_tf", u8g2_font_fur42_tf },
  { "u8g2_font_osb18_tf", u8g2_font_osb18_tf },
  { "u8g2_font_osb21_tf", u8g2_font_osb21_tf },
  { "u8g2_font_osb26_tf", u8g2_font_osb26_tf },
  { "u8g2_font_osb29_tf", u8g2_font_osb29_tf },
  { "u8g2_font_osb35_tf", u8g2_font_osb35_tf },
  { "u8g2_font_osb41_tf", u8g2_font_osb41_tf },
  { "u8g2_font_osr18_tf", u8g2_font_osr18_tf },
  { "u8g2_font_osr21_tf", u8g2_font_osr21_tf },
  { "u8g2_font_osr26_tf", u8g2_font_osr26_tf },
  { "u8g2_font_osr29_tf", u8g2_font_osr29_tf },
  { "u8g2_font_osr35_tf", u8g2_font_osr35_tf },
  { "u8g2_font_osr41_tf", u8g2_font_osr41_tf },
  { "u8g2_font_logisoso16_tf", u8g2_font_logisoso16_tf },
  { "u8g2_font_logisoso18_tf", u8g2_font_logisoso18_tf },
  { "u8g2_font_logisoso20_tf", u8g2_font_logisoso20_tf },
  { "u8g2_font_logisoso22_tf", u8g2_font_logisoso22_tf },
  { "u8g2_font_logisoso24_tf", u8g2_font_logisoso24_tf },
  { "u8g2_font_logisoso26_tf", u8g2_font_logisoso26_tf },
  { "u8g2_font_logisoso28_tf", u8g2_font_logisoso28_tf },
  { "u8g2_font_logisoso30_tf", u8g2_font_logisoso30_tf },
  { "u8g2_font_logisoso32_tf", u8g2_font_logisoso32_tf },
  { "u8g2_font_logisoso34_tf", u8g2_font_logisoso34_tf },
  { "u8g2_font_logisoso38_tf", u8g2_font_logisoso38_tf },
  { "u8g2_font_logisoso42_tf", u8g2_font_logisoso42_tf },
  { "u8g2_font_logisoso46_tf", u8g2_font_logisoso46_tf },
  { "u8g2_font_logisoso50_tf", u8g2_font_logisoso50_tf },
  { "u8g2_font_logisoso54_tf", u8g2_font_logisoso54_tf },
  { "u8g2_font_logisoso58_tf", u8g2_font_logisoso58_tf },
  { "u8g2_font_pxplusibmvga9_tf", u8g2_font_pxplusibmvga9_tf },
  { "u8g2_font_pxplusibmvga8_tf", u8g2_font_pxplusibmvga8_tf },
  { "u8g2_font_px437wyse700a_tf", u8g2_font_px437wyse700a_tf },
  { "u8g2_font_px437wyse700b_tf", u8g2_font_px437wyse700b_tf }
/*  
*/
};

void TestAllFonts() {
  for (const auto &font : TF_FONTS ) {
    u8g2.setFont( font.font );
    Serial.printf( "%s %d %d\n", font.fontName, u8g2.getMaxCharHeight(), u8g2.getUTF8Width( "ABCabc123" ) );
  }
};
