henkjannl/BedClock/04_Software/_Feasibility/13_WheaterIcons/13_WheaterIcons.ino

using namespace std;

enum tWeatherIcon  { icon01d, icon01n, icon02d, icon02n, icon03d, icon03n, icon04d, icon04n, icon09d, 
                     icon09n, icon10d, icon10n, icon11d, icon11n, icon13d, icon13n, icon50d, icon50n };

static const unsigned char icons[][128] = {
  // 01d
  {  0x00, 0x00, 0x00, 0x00, 0x00, 0x00, 0x00, 0x00, 0x00, 0x00, 0x00, 0x00,     
     0x00, 0x00, 0x00, 0x00, 0x00, 0x00, 0x00, 0x00, 0x00, 0x00, 0x00, 0x00,
     0x00, 0x00, 0x00, 0x00, 0x00, 0xa0, 0x03, 0x00, 0x00, 0xf0, 0x0f, 0x00,
     0x00, 0xfc, 0x3f, 0x00, 0x00, 0xfe, 0x7f, 0x00, 0x00, 0xfe, 0x7f, 0x00,
     0x00, 0xff, 0xff, 0x00, 0x00, 0xff, 0xff, 0x00, 0x80, 0xff, 0xff, 0x01,
     0x80, 0xff, 0xff, 0x01, 0x80, 0xff, 0xff, 0x01, 0x80, 0xff, 0xff, 0x01,
     0x00, 0xff, 0xff, 0x00, 0x00, 0xff, 0xff, 0x00, 0x00, 0xff, 0x7f, 0x00,
     0x00, 0xfe, 0x7f, 0x00, 0x00, 0xfc, 0x3f, 0x00, 0x00, 0xf0, 0x0f, 0x00,
     0x00, 0xc0, 0x05, 0x00, 0x00, 0x00, 0x00, 0x00, 0x00, 0x00, 0x00, 0x00,
     0x00, 0x00, 0x00, 0x00, 0x00, 0x00, 0x00, 0x00, 0x00, 0x00, 0x00, 0x00,
     0x00, 0x00, 0x00, 0x00, 0x00, 0x00, 0x00, 0x00 },

  // 01n 
   { 0x00, 0x00, 0x00, 0x00, 0x00, 0x00, 0x00, 0x00, 0x00, 0x00, 0x00, 0x00,
     0x00, 0x00, 0x00, 0x00, 0x00, 0x40, 0x00, 0x00, 0x00, 0xc0, 0x07, 0x00,
     0x00, 0x80, 0x0f, 0x00, 0x00, 0x80, 0x3f, 0x00, 0x00, 0x00, 0x7f, 0x00,
     0x00, 0x00, 0x7e, 0x00, 0x00, 0x00, 0xfe, 0x00, 0x00, 0x00, 0xfe, 0x01,
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
     0x00, 0x48, 0x12, 0x00, 0x00, 0xff, 0x3f, 0x00, 0x00, 0x00, 0x00, 0x00,
     0x00, 0x00, 0x00, 0x00, 0x00, 0x00, 0x00, 0x00, 0x00, 0x00, 0x00, 0x00,
     0x00, 0x00, 0x00, 0x00, 0x00, 0x00, 0x00, 0x00, 0x00, 0x00, 0x00, 0x00,
     0x00, 0x00, 0x00, 0x00, 0x00, 0x00, 0x00, 0x00 },

   // 50n
   { 0x00, 0x00, 0x00, 0x00, 0x00, 0x00, 0x00, 0x00, 0x00, 0x00, 0x00, 0x00,
     0x00, 0x00, 0x00, 0x00, 0x00, 0x00, 0x00, 0x00, 0x00, 0x00, 0x00, 0x00,
     0x00, 0x00, 0x00, 0x00, 0x00, 0x00, 0x00, 0x00, 0x00, 0x00, 0x00, 0x00,
     0x00, 0xf0, 0x07, 0x00, 0x00, 0x20, 0x01, 0x00, 0x00, 0x00, 0x00, 0x00,
     0xe0, 0xff, 0xf7, 0x01, 0x40, 0xdb, 0xa2, 0x00, 0x00, 0x00, 0x00, 0x00,
     0x00, 0xfe, 0xfc, 0x01, 0x00, 0xfe, 0xf4, 0x01, 0x00, 0x00, 0x00, 0x00,
     0xc0, 0xb6, 0xa5, 0x01, 0xe0, 0xff, 0xe7, 0x01, 0x00, 0x00, 0x00, 0x00,
     0x00, 0x48, 0x12, 0x00, 0x00, 0xff, 0x3f, 0x00, 0x00, 0x00, 0x00, 0x00,
     0x00, 0x00, 0x00, 0x00, 0x00, 0x00, 0x00, 0x00, 0x00, 0x00, 0x00, 0x00,
     0x00, 0x00, 0x00, 0x00, 0x00, 0x00, 0x00, 0x00, 0x00, 0x00, 0x00, 0x00,
     0x00, 0x00, 0x00, 0x00, 0x00, 0x00, 0x00, 0x00 }
  };


void setup() {
  Serial.begin(115200);
  Serial.println(icons[0][3]);

}

void loop() {
  // put your main code here, to run repeatedly:

}
