henkjannl/BedClock/04_Software/Bedclock_IDF_V12/src/bl_display.h

#include <stdio.h>
#include "driver/i2c.h"
#include "esp_lcd_panel_io.h"
#include "esp_lcd_panel_vendor.h"
#include "esp_lcd_panel_ops.h"
#include "esp_system.h"
#include "esp_lcd_io_i2c.h"
#include "esp_err.h"
#include "esp_log.h"

#include "bl_common.h"
#include "hp_timer.h"
#include "hp_stepping_float.h"
#include "hp_pixel_buffer.h"
#include "hp_pixel_canvas.h"

#include "fonts\hp_time_font.h"
#include "fonts\hp_version_font_8px.h"
#include "fonts\hp_version_font_10px.h"

#define MAX_DISPLAY_ITEM 6
#define dp_tag "display"

/* ===================================
     Bitmaps to build up the screen
   ===================================*/
static uint8_t labels_bytes[] = {
    0x02,0x00,0x00,0x00,0x02,0x00,0x02,0x08,0x00,0x00,0x10,0x00,0xd2,0x9c,0xd3,
    0x78,0xba,0x08,0x32,0x49,0x34,0x05,0x92,0x08,0x12,0x49,0x14,0x39,0x92,0x04,
    0x12,0xc9,0x17,0x41,0x12,0x05,0x12,0x49,0x10,0x41,0x12,0x02,0x12,0x99,0x13,
    0x3d,0x32,0x02,0x00,0x00,0x00,0x00,0x00,0x02,0x00,0x00,0x00,0x00,0x00,0x01,
    0x00,0x00,0x00,0x00,0x00,0x00,0x00,0x00,0x00,0x00,0x00,0x00,0x1c,0x40,0x00,
    0x00,0x00,0x00,0x22,0x40,0x00,0x00,0x00,0x00,0x02,0x40,0x00,0x00,0x00,0x00,
    0x02,0x4e,0x1c,0x07,0x00,0x00,0x02,0x51,0x22,0x01,0x00,0x00,0x02,0x51,0x22,
    0x01,0x00,0x00,0x02,0x51,0x22,0x01,0x00,0x00,0x22,0x51,0x22,0x01,0x00,0x00,
    0x1c,0x8e,0x1c,0x01,0x00,0x00,0x00,0x00,0x00,0x00,0x00,0x00,0x00,0x00,0x00,
    0x00,0x00,0x00,0x00,0x00,0x00,0x00,0x00,0x00,0x00,0x00,0x00,0x00,0x00,0x00,
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
const int16_t Y_POS[] = {
    27, // 0 = Display sleeping
     0, // 1 = Showing time
   -26, // 2 = LED Intensity
   -38, // 3 = LED Color
   -50, // 4 = LED timer
   -62  // 5 = Display timer
};

// Indicator
const int16_t Y_IND[] = {
    -1, // 0 = Display sleeping, indicator should remain at current position
    -1, // 1 = Showing time,     indicator should remain at current position
    36, // 2 = LED Intensity
    48, // 3 = LED Color
    60, // 4 = LED timer
    72  // 5 = Display timer
};

const char* LED_INTENSITY_CH[] = { "2.5%", "6%", "16%", "40%", "100%" };
const char* LED_COLOR_CH[] =      {"6500K", "5000K", "4000K", "3000K" };
const char* LED_TIME_CH[] =      {"5min", "7min", "10min", "14min", "20min" };
const char* DISPLAY_CH[] =      {"Low", "Med", "High" };

/* ===================================
     Configuration data of the display
   ===================================*/
#define MN_LCD_H_RES          128
#define MN_LCD_V_RES          32
#define MN_I2C_HOST_ID        I2C_NUM_0
#define MN_I2C_SDA_GPIO       21
#define MN_I2C_SCL_GPIO       22
#define MN_LCD_PIXEL_CLOCK_HZ (370 * 1000)
#define MN_I2C_DEV_ADDR       0x3C

const i2c_config_t conf = {
    .mode             = I2C_MODE_MASTER,
    .sda_io_num       = MN_I2C_SDA_GPIO,
    .scl_io_num       = MN_I2C_SCL_GPIO,
    .sda_pullup_en    = GPIO_PULLUP_ENABLE,
    .scl_pullup_en    = GPIO_PULLUP_ENABLE,
    .master.clk_speed = MN_LCD_PIXEL_CLOCK_HZ,
};

esp_lcd_panel_io_handle_t io_handle;

esp_lcd_panel_io_i2c_config_t io_config = {
    .dev_addr = MN_I2C_DEV_ADDR,
    .control_phase_bytes = 1,  // According to SSD1306 datasheet
    .dc_bit_offset       = 6,  // According to SSD1306 datasheet
    .lcd_cmd_bits        = 8,  // According to SSD1306 datasheet
    .lcd_param_bits      = 8,  // According to SSD1306 datasheet
};

esp_lcd_panel_handle_t panel_handle = NULL;

esp_lcd_panel_ssd1306_config_t esp_lcd_panel_ssd1306_config = {
    .height = 32,
};

esp_lcd_panel_dev_config_t panel_config = {
    .bits_per_pixel = 1,
    .reset_gpio_num = -1,
    .vendor_config = &esp_lcd_panel_ssd1306_config,
};

void display_contrast(uint8_t contrast) {
    esp_lcd_panel_io_tx_param(io_handle, 0x81, &contrast, 1);
}

void display_refresh(int16_t y, uint8_t indicator_y) {
    uint8_t num_chars;
    char buffer [50];
    int16_t x;

    // Copy settings to a temporary struct
    static common_settings_t settings;
    if (xSemaphoreTake(mutex_change_settings, portMAX_DELAY) == pdTRUE) {
        settings = common_settings;
        xSemaphoreGive(mutex_change_settings);
    }

    // Retrieve time
    time_t now = 0;
    struct tm timeinfo = { 0 };
    time(&now);
    localtime_r(&now, &timeinfo);
    if(timeinfo.tm_year+1900 < 2020)
        num_chars = sprintf(buffer, "--:--");
    else
        num_chars = sprintf(buffer, "%02d:%02d", timeinfo.tm_hour, timeinfo.tm_min);

    display_contrast(DISPLAY_INTENSITY[settings.display_intensity]);

    hp_bitmap_clear_canvas();
    x = 64-(hp_bitmap_text_width(hp_time_font, (unsigned char*) buffer, num_chars)>>1);
    hp_bitmap_draw_text(hp_time_font, x, y+7, (unsigned char*) buffer, num_chars);
    hp_bitmap_draw_bitmap(&labels, 10, y+36);
    hp_bitmap_draw_bitmap(&circle_closed, 0, y+indicator_y);

    // Display current settings
    hp_bitmap_draw_text(hp_version_font_10px, 58, y+Y_IND[2],
        (unsigned char*) LED_INTENSITY_CH[settings.led_intensity],
        strlen(LED_INTENSITY_CH[settings.led_intensity]) );

    hp_bitmap_draw_text(hp_version_font_10px, 58, y+Y_IND[3],
        (unsigned char*) LED_COLOR_CH[settings.led_color],
        strlen(LED_COLOR_CH[settings.led_color]) );

    hp_bitmap_draw_text(hp_version_font_10px, 58, y+Y_IND[4],
        (unsigned char*) LED_TIME_CH[settings.led_timer],
        strlen(LED_TIME_CH[settings.led_timer]) );

    hp_bitmap_draw_text(hp_version_font_10px, 58, y+Y_IND[5],
        (unsigned char*) DISPLAY_CH[settings.display_intensity],
        strlen(DISPLAY_CH[settings.display_intensity]) );

    // Upload the pixel buffer to the SSD1306
    hp_bitmap_write_canvas(panel_handle);
}

void task_display(void *z)
{
    bool refresh_display = true;
    bool animation_still_running = false;
    common_command_t cmd = CMD_NONE;
    hp_timer_t sleep_timer;          hp_timer_init_ms(&sleep_timer, 20000, false);
    hp_stepping_float_t screen_y;    hp_stepping_float_init(&screen_y, 26, 0, 25, ST_CLICK);
    hp_stepping_float_t indicator_y; hp_stepping_float_init(&indicator_y, 36, 36, 16, ST_SPRING);

    while(true) {

        if (xQueueReceive(display_queue, &cmd, pdMS_TO_TICKS(100)) == true) {
            switch(cmd) {
                case CMD_BTN_LEFT_PRESSED:
                    ESP_LOGI(dp_tag, "item received BTN_LEFT");
                    hp_timer_reset(&sleep_timer);
                    common_increment_selected_item();

                    // Move the display to a new target
                    uint8_t selected_item = common_get_selected_item();

                    hp_stepping_float_target(&screen_y, Y_POS[selected_item], selected_item==0 ? 20 : 10);
                    if (selected_item>1) hp_stepping_float_target(&indicator_y, Y_IND[selected_item],  6);

                    refresh_display = true;
                break;

                case CMD_BTN_RIGHT_PRESSED:
                    ESP_LOGI(dp_tag, "item received BTN_RIGHT");
                    hp_timer_reset(&sleep_timer);

                    switch(common_get_selected_item()) {

                        case 0: // Wake up clock
                            ESP_LOGI(dp_tag, "Wake up clock on right button");
                            common_change_selected_item(1);
                            hp_stepping_float_target(&screen_y, Y_POS[1], 8);
                            refresh_display = true;
                            break;

                        case 2: // Modify LED intensity
                            ESP_LOGI(dp_tag, "Increase LED intensity");
                            common_increment_led_intensity();
                            queue_send_message(light_queue, CMD_ADJUST_LIGHT);
                            refresh_display = true;
                        break;

                        case 3: // Modify LED color
                            ESP_LOGI(dp_tag, "Increase LED color");
                            common_increment_led_color();
                            queue_send_message(light_queue, CMD_ADJUST_LIGHT);
                            refresh_display = true;
                        break;

                        case 4: // Modify LED timer
                            ESP_LOGI(dp_tag, "Increase LED timer");
                            common_increment_led_timer();
                            queue_send_message(light_queue, CMD_TIMER_CHANGED);
                            refresh_display = true;
                        break;

                        case 5: // Modify display intensity
                            common_increment_display_intensity();
                            ESP_LOGI(dp_tag, "Modify display intensity %d", common_get_display_intensity());
                            refresh_display = true;
                        break;


                        default:
                            ESP_LOGI(dp_tag, "Item %d cannot be changed ", common_settings.selected_item);
                    } // case CMD_BTN_RIGHT_PRESSED -> switch(common_settings.selected_item) {
                break;

                case CMD_LIGHT_SWITCHES_ON:
                    ESP_LOGI(dp_tag, "Light switches on, show clock");
                    if( common_get_selected_item()==0 ) {
                        common_change_selected_item(1);
                        hp_stepping_float_target(&screen_y, Y_POS[1], 30);
                        refresh_display = true;
                    }

                    if( common_get_selected_item()==1 ) {
                        // Kill the sleep timer, so clock only removed when LED switches off
                        hp_timer_set_lapsed(&sleep_timer);
                        ESP_LOGI(dp_tag, "hp_timer_lapsed = %s ", hp_timer_lapsed(&sleep_timer) ? "yes" : "no");
                    }
                break;

                case CMD_LIGHT_SWITCHES_OFF:
                    ESP_LOGI(dp_tag, "Light switches off, remove clock too");
                    if( common_get_selected_item()==1 ) {
                        common_change_selected_item(0);
                        hp_stepping_float_target(&screen_y, Y_POS[0], 30);
                        refresh_display = true;
                    }
                break;

                default:
                    ESP_LOGI(dp_tag, "Received handled button");
            } // switch(cmd) {
        } // if (xQueueReceive(display_queue

        if(hp_timer_lapsed(&sleep_timer)) {
            ESP_LOGI(dp_tag, "Display back to sleep");
            common_change_selected_item(0);
            hp_stepping_float_target(&screen_y, Y_POS[0], 15);

            // Check if we need to save settings
            common_save();

            refresh_display = true;
        } // if(hp_timer_lapsed(&sleep_timer))

        // Refresh display if minute has changed
        if(common_settings.selected_item>0) {
            time_t now = 0;
            struct tm timeinfo = { 0 };
            time(&now);
            localtime_r(&now, &timeinfo);
            static int prev_min = -1;
            if( prev_min != timeinfo.tm_min ) {
                ESP_LOGI(dp_tag, "Update clock due to minute change");
                prev_min = timeinfo.tm_min;
                refresh_display=true;
            }
        }

        // Also refresh display if animation is still going on
        // Not a pretty solution, but before introducing animation_still_running,
        // the last frame of the animation was not shown
        hp_stepping_float_step(&screen_y);
        hp_stepping_float_step(&indicator_y);
        if(!hp_stepping_float_finished(&screen_y)) animation_still_running=true;
        if(!hp_stepping_float_finished(&indicator_y)) animation_still_running=true;
        if(animation_still_running) refresh_display = true;

        if(refresh_display) {
            display_refresh( (int16_t) screen_y.value, (int16_t) indicator_y.value );
            refresh_display = false;
        } // if(refresh_display) {

        // After refreshing display, decide if animation has stopped
        if(hp_stepping_float_finished(&screen_y)) animation_still_running=false;
        if(hp_stepping_float_finished(&indicator_y)) animation_still_running=false;

        vTaskDelay(pdMS_TO_TICKS(2));
    } // while true
} // void task_display(void *z)

void display_init(const char* version) {
    // Initialize the OLED display
    ESP_ERROR_CHECK(i2c_param_config(MN_I2C_HOST_ID, &conf));
    ESP_ERROR_CHECK(i2c_driver_install(MN_I2C_HOST_ID, I2C_MODE_MASTER, 0, 0, 0));
    io_handle = NULL;
    esp_lcd_new_panel_io_i2c( (esp_lcd_i2c_bus_handle_t)MN_I2C_HOST_ID, &io_config, &io_handle);
    esp_lcd_new_panel_ssd1306(io_handle, &panel_config, &panel_handle);
    esp_lcd_panel_reset(panel_handle);
    esp_lcd_panel_init(panel_handle);
    esp_lcd_panel_disp_on_off(panel_handle, true);

    display_contrast(common_get_display_intensity() );

    // Start with the splash screen showing the software version
    hp_bitmap_clear_canvas();
    hp_bitmap_draw_bitmap(&splash_screen, 24, 0);
    int16_t x  = (128-hp_bitmap_text_width(hp_version_font_8px, (const unsigned char*) version, strlen(version))) >> 1;
    hp_bitmap_draw_text(hp_version_font_8px, x, 9, (const unsigned char*) version, strlen(version));
    hp_bitmap_write_canvas(panel_handle);

    vTaskDelay(pdMS_TO_TICKS(2000));

    xTaskCreatePinnedToCore(task_display, "task_display", 4096, NULL, 1, NULL, 0);
}
