henkjannl/BedClock/04_Software/_Feasibility/10_Icons_and_pins/Icons.h

#ifndef ICONS_H
#define ICONS_H

/*
  0 Timer
  1 Intensity
  2 Color
  3 Exit
  4 Timer03
  5 Timer05
  6 Timer10
  7 Timer20
  8 Intensity025
  9 Intensity035
  10 Intensity050
  11 Intensity070
  12 Intensity100
  13 White
  14 Yellow
  15 Orange
  16 Red
  17 ExitCancel
  18 ExitConfirm
*/

const int icon_width  = 20;
const int icon_height = 20;
const int icon_pitch  = icon_width+2;

static const unsigned char icons[][128] U8X8_PROGMEM  = {
    { // 0 Timer
   0x00, 0x06, 0x00, 0x20, 0x46, 0x00, 0x40, 0x20, 0x00, 0x00, 0x06, 0x00,
   0x00, 0x06, 0x00, 0x02, 0x06, 0x04, 0x04, 0x06, 0x02, 0x00, 0x06, 0x00,
   0x00, 0x06, 0x00, 0x03, 0x06, 0x0c, 0x03, 0x06, 0x0c, 0x00, 0x0e, 0x00,
   0x00, 0x1e, 0x00, 0x04, 0x3c, 0x02, 0x02, 0x78, 0x04, 0x00, 0x30, 0x00,
   0x00, 0x00, 0x00, 0x40, 0x20, 0x00, 0x20, 0x46, 0x00, 0x00, 0x06, 0x00 },

    { // 1 Intensity
   0x80, 0x0f, 0x00, 0xe0, 0x7f, 0x00, 0xf8, 0xe7, 0x00, 0xfc, 0x87, 0x01,
   0xfc, 0x07, 0x03, 0xfe, 0x07, 0x06, 0xff, 0x07, 0x06, 0xff, 0x07, 0x0c,
   0xff, 0x07, 0x0c, 0xff, 0x07, 0x0c, 0xff, 0x07, 0x0c, 0xff, 0x07, 0x0c,
   0xff, 0x07, 0x0c, 0xfe, 0x07, 0x06, 0xfe, 0x07, 0x06, 0xfc, 0x07, 0x03,
   0xfc, 0x87, 0x01, 0xf8, 0xf7, 0x01, 0xe0, 0x7f, 0x00, 0x80, 0x0f, 0x00 },

    { // 2 Color
   0x00, 0x02, 0x00, 0x80, 0x1f, 0x00, 0xe0, 0x79, 0x00, 0x60, 0x60, 0x00,
   0x30, 0xc0, 0x00, 0x30, 0xc0, 0x00, 0x30, 0xc0, 0x00, 0xf0, 0xf9, 0x00,
   0xfc, 0xff, 0x03, 0x7e, 0xef, 0x07, 0xe6, 0x7f, 0x06, 0xc3, 0x3f, 0x0c,
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
   0xff, 0xff, 0x3f, 0x00, 0x00, 0x00, 0x00, 0xe0, 0x0e, 0x00, 0x00, 0x00,
   0x00, 0xfc, 0xff, 0xff, 0xfe, 0xff, 0x1f, 0x00, 0x00, 0x00, 0x00, 0x60,
   0x0c, 0x00, 0x00, 0x00, 0x00, 0xf8, 0xff, 0x7f, 0xfc, 0xff, 0x0f, 0x00,
   0x00, 0x00, 0x00, 0x38, 0x38, 0x00, 0x00, 0x00, 0x00, 0xf0, 0xff, 0x3f,
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


#endif // ICONS_H
