henkjannl/BedClock/04_Software/Bedclock_IDF_V12/src/bl_time.h

#include <string.h>
#include "freertos/FreeRTOS.h"
#include "freertos/task.h"
#include "freertos/event_groups.h"
#include "esp_system.h"
#include "esp_wifi.h"
#include "esp_event.h"
#include "esp_log.h"
#include "nvs_flash.h"

#include "lwip/err.h"
#include "lwip/sys.h"

#include <time.h>
#include <sys/time.h>
#include "esp_attr.h"
#include "esp_sleep.h"
#include "esp_netif_sntp.h"
#include "lwip/ip_addr.h"
#include "esp_sntp.h"

#include <stdio.h>
#include <stdlib.h>   // for putenv

#include "config.h" // Contains access point and password, excluded from github

/*
To do

Waiting for time is now blocking, this should be avoided using appropriate callback routines
    while (esp_netif_sntp_sync_wait(2000 / portTICK_PERIOD_MS) == ESP_ERR_TIMEOUT && ++retry < retry_count) {

Add coredump to partition table
*/

/* Config.h is in gitignore, to prevent exposing private data on github 
It should contain the following defines
#define WIFI_SSID      "...."
#define WIFI_PASS      "...."

If the application generates the following error:

W (782) phy_init: failed to load RF calibration data (0xffffffff), falling back to full calibration

Change menuconfig setting:

Component config --> PHY --> Store phy calibration data in NVS --> [*]
Component config --> PHY --> Use a partition to store PHY init data --> Reset default PHY init data if invalid --> [*]
Component config --> LWIP --> Enable LwIP stack --> [*]
Component config --> LWIP --> SNTP --> Maximum number of NTP servers --> [1]
Component config --> LWIP --> SNTP --> Request NTP servers from DHCP --> [*]



Partition table (default):
I (211) boot: ## Label            Usage          Type ST Offset   Length
I (219) boot:  0 nvs              WiFi data        01 02 00009000 00006000
I (226) boot:  1 phy_init         RF data          01 01 0000f000 00001000
I (234) boot:  2 factory          factory app      00 00 00010000 00100000
*/

#define ESP_WIFI_SCAN_AUTH_MODE_THRESHOLD  WIFI_AUTH_OPEN
#define ESP_WIFI_SAE_MODE                  WPA3_SAE_PWE_UNSPECIFIED

#define ESP_MAXIMUM_RETRY  10

/* FreeRTOS event group to signal when we are connected*/
static EventGroupHandle_t s_wifi_event_group;

/* The event group allows multiple bits for each event, but we only care about two events:
 * - we are connected to the AP with an IP
 * - we failed to connect after the maximum amount of retries */
#define WIFI_CONNECTED_BIT BIT0
#define WIFI_FAIL_BIT      BIT1

static const char *tm_tag = "wifi station";

static int s_retry_num = 0;


static void event_handler(void* arg, esp_event_base_t event_base,
                                int32_t event_id, void* event_data)
{
    if (event_base == WIFI_EVENT && event_id == WIFI_EVENT_STA_START) {
        esp_wifi_connect();
    } else if (event_base == WIFI_EVENT && event_id == WIFI_EVENT_STA_DISCONNECTED) {
        if (s_retry_num < ESP_MAXIMUM_RETRY) {
            esp_wifi_connect();
            s_retry_num++;
            ESP_LOGI(tm_tag, "retry to connect to the AP");
        } else {
            xEventGroupSetBits(s_wifi_event_group, WIFI_FAIL_BIT);
        }
        ESP_LOGI(tm_tag,"connect to the AP fail");
    } else if (event_base == IP_EVENT && event_id == IP_EVENT_STA_GOT_IP) {
        ip_event_got_ip_t* event = (ip_event_got_ip_t*) event_data;
        ESP_LOGI(tm_tag, "got ip:" IPSTR, IP2STR(&event->ip_info.ip));
        s_retry_num = 0;
        xEventGroupSetBits(s_wifi_event_group, WIFI_CONNECTED_BIT);
    }
}

void wifi_init_sta(void)
{
    s_wifi_event_group = xEventGroupCreate();

    ESP_ERROR_CHECK(esp_netif_init());

    ESP_ERROR_CHECK(esp_event_loop_create_default());
    esp_netif_create_default_wifi_sta();

    wifi_init_config_t cfg = WIFI_INIT_CONFIG_DEFAULT();
    ESP_ERROR_CHECK(esp_wifi_init(&cfg));

    esp_event_handler_instance_t instance_any_id;
    esp_event_handler_instance_t instance_got_ip;
    ESP_ERROR_CHECK(esp_event_handler_instance_register(WIFI_EVENT,
                                                        ESP_EVENT_ANY_ID,
                                                        &event_handler,
                                                        NULL,
                                                        &instance_any_id));
    ESP_ERROR_CHECK(esp_event_handler_instance_register(IP_EVENT,
                                                        IP_EVENT_STA_GOT_IP,
                                                        &event_handler,
                                                        NULL,
                                                        &instance_got_ip));

    wifi_config_t wifi_config = {
        .sta = {
            .ssid = WIFI_SSID,
            .password = WIFI_PASS,
            /* Authmode threshold resets to WPA2 as default if password matches WPA2 standards (pasword len => 8).
             * If you want to connect the device to deprecated WEP/WPA networks, Please set the threshold value
             * to WIFI_AUTH_WEP/WIFI_AUTH_WPA_PSK and set the password with length and format matching to
             * WIFI_AUTH_WEP/WIFI_AUTH_WPA_PSK standards.
             */
            .threshold.authmode = ESP_WIFI_SCAN_AUTH_MODE_THRESHOLD,
            .sae_pwe_h2e = ESP_WIFI_SAE_MODE,
            .sae_h2e_identifier = WIFI_PASS,
        },
    };
    ESP_ERROR_CHECK(esp_wifi_set_mode(WIFI_MODE_STA) );
    ESP_ERROR_CHECK(esp_wifi_set_config(WIFI_IF_STA, &wifi_config) );
    ESP_ERROR_CHECK(esp_wifi_start() );

    ESP_LOGI(tm_tag, "wifi_init_sta finished.");

    /* Waiting until either the connection is established (WIFI_CONNECTED_BIT) or connection failed for the maximum
     * number of re-tries (WIFI_FAIL_BIT). The bits are set by event_handler() (see above) */
    EventBits_t bits = xEventGroupWaitBits(s_wifi_event_group,
            WIFI_CONNECTED_BIT | WIFI_FAIL_BIT,
            pdFALSE,
            pdFALSE,
            portMAX_DELAY);

    /* xEventGroupWaitBits() returns the bits before the call returned, hence we can test which event actually
     * happened. */
    if (bits & WIFI_CONNECTED_BIT) {
        ESP_LOGI(tm_tag, "connected to ap SSID:%s password:%s",
                 WIFI_SSID, WIFI_PASS);
    } else if (bits & WIFI_FAIL_BIT) {
        ESP_LOGI(tm_tag, "Failed to connect to SSID:%s, password:%s",
                 WIFI_SSID, WIFI_PASS);
    } else {
        ESP_LOGE(tm_tag, "UNEXPECTED EVENT");
    }
}

void time_init(void)
{
    //Initialize NVS
    esp_err_t ret = nvs_flash_init();
    if (ret == ESP_ERR_NVS_NO_FREE_PAGES || ret == ESP_ERR_NVS_NEW_VERSION_FOUND) {
      ESP_ERROR_CHECK(nvs_flash_erase());
      ret = nvs_flash_init();
    }
    ESP_ERROR_CHECK(ret);

    // Initialize wifi station that connects to an access point
    ESP_LOGI(tm_tag, "ESP_WIFI_MODE_STA");
    wifi_init_sta();

    // Initialize the Simple Network Time Protocol (SNTP)
    ESP_LOGI(tm_tag, "Initializing SNTP");
    esp_sntp_config_t config = ESP_NETIF_SNTP_DEFAULT_CONFIG("pool.ntp.org");
    config.start = false;                       // start SNTP service explicitly (after connecting)
    config.server_from_dhcp = true;             // accept NTP offers from DHCP server, if any (need to enable *before* connecting)
    config.renew_servers_after_new_IP = true;   // let esp-netif update configured SNTP server(s) after receiving DHCP lease
    config.index_of_first_server = 1;           // updates from server num 1, leaving server 0 (from DHCP) intact
    config.ip_event_to_renew = IP_EVENT_STA_GOT_IP;
    // config.sync_cb = time_sync_notification_cb; // only if we need the notification function
    esp_netif_sntp_init(&config);

    ESP_LOGI(tm_tag, "Starting SNTP");
    esp_netif_sntp_start();

    // Wait for time to be set
    // To do: this should not be a blocking while loop
    time_t now = 0;
    struct tm timeinfo = { 0 };
    int retry = 0;
    const int retry_count = 15;
    while (esp_netif_sntp_sync_wait(2000 / portTICK_PERIOD_MS) == ESP_ERR_TIMEOUT && ++retry < retry_count) {
        ESP_LOGI(tm_tag, "Waiting for system time to be set... (%d/%d)", retry, retry_count);
    }
    setenv("TZ", TIME_ZONE,1);
    tzset();

    time(&now);
    localtime_r(&now, &timeinfo);

    printf("Local time in Amsterdam: %02d:%02d:%02d\n", timeinfo.tm_hour, timeinfo.tm_min, timeinfo.tm_sec);   

    // esp_netif_sntp_deinit();
}
