henkjannl/BedClock/04_Software/_Feasibility/11_NewGUI/display.h

#ifndef DISPLAY_H
#define DISPLAY_H

#include <U8g2lib.h>
#include <list>
#include "gui.h"

using namespace std;

enum tMainMenu       { mmBrightness, mmColor, mmTimer, mmBack};
enum tBrightnessMenu { bm25, bm35, bm50, bm70, bm100, bmBack};
enum tColorMenu      { cmWhite, cmYellow, cmOrange, cmRed, cmBack};
enum tTimerMenu      { tm3, tm5, tm10, tm20, tmOff, tmBack};

class tDisplay {

  public:
    // Main canvas
    tGroup  grpMain; 
    tLabel  lblTime; 
  
    // Top row with first row of buttons
    tGroup  rowMain;     
    tButton btnBrightness;  
    tButton btnColor;
    tButton btnTimer;
    tButton btnBack;
  
    // Second row on brightness
    tGroup  rowBrightness;
    tButton btnBrightness25;
    tButton btnBrightness35;
    tButton btnBrightness50;
    tButton btnBrightness70;
    tButton btnBrightness100;
    tButton btnBrightnessBack;
    
    // Second row on color
    tGroup  rowColor;
    tButton btnColorWhite;
    tButton btnColorYellow;
    tButton btnColorOrange;
    tButton btnColorRed;
    tButton btnColorBack;

    // Second row on timer  
    tGroup rowTimer;
    tButton btnTimer03;
    tButton btnTimer05;
    tButton btnTimer10;
    tButton btnTimer20;
    tButton btnTimerOff;
    tButton btnTimerBack;

    // Sequencing the movements
    bool ready() { return grpMain.ready(); };

    // Current selection in the menu
    tMainMenu       mainMenu;
    tBrightnessMenu brightnessMenu;
    tColorMenu      colorMenu;
    tTimerMenu      timerMenu;

    // Currently selected row
    int selectedRow;

    // Input from buttons
    void nextButton();
    void selectButton();
  
    tDisplay(U8G2 &u8g2);
    void step();
    void display(U8G2 &u8g2) { grpMain.draw(u8g2); };
    void showMain();
    void showTopRow();
    void showSecondRow();

  protected:
    void addToRow(U8G2 &u8g2, tGroup* row, tButton* button, tButton* prevButton, string label);
    void selectNextItem(tGroup* row, tButton* btnCurrent, tButton* btnNew, tButton* btnRight);
};

#endif // DISPLAY_H
