henkjannl/BedClock/(commit log)

2021-04-11 Weather added, menu close bug fixed
    [main.cpp]
2021-04-11 Updated project plan
    [Projectplan.ods, Projectplan.xlsx]
2021-04-18 Feasibility of U2G2 with new screen layout added
    [Icons.xlsx, Projectplan.xlsx, User interface states.ods, User interface.xlsx]
2021-04-18 Scanning of pins added to feasability project
    [Brightness steps.xlsx]
2021-05-14 Prototype new user interface
2021-05-15 New display gui works with light, timer and clock not yet implemented
2021-05-28 FreeRTOS implemented to get snappy interface
    [Bottom.stl]
2021-06-06 Weather integration completed
    [Projectplan.xlsx]
2021-06-12 Screen contrast added, including auto screen contrast
    [Auto intensity calculation example.xlsx, Projectplan.xlsx]
2022-12-19 Rethink architecture
    [Reorganize architecture (work in progress).ods]
2022-12-22 Update Reorganize architecture (work in progress).ods
    [Reorganize architecture (work in progress).ods]
2023-01-20 Telegram version added (concept)
    [NightLight rotary.FCStd]
2023-02-18 Buttons and screen added
2023-02-20 Include outside temperature
2023-02-26 Timers in separate class
    [Height and width of many TF fonts.ods]
2023-03-11 Weather icons reintroduced
    [Height and width of many TF fonts.ods]
2023-03-14 Fixed missing weather icon
    [b_Icons.h, e_Telegram.h, f_Display.h, g_Weather.h]
2023-03-17 V2 final
    [Bridge.stl, LED bridge.stl]
2023-03-29 V1.6 max day temp
    [Height and width of many TF fonts.ods]
2023-06-13 Fixed JSON parse error for weatherinfo
    [j_Weather.h]
2024-10-05 Redesign software
    [partitions.csv]
2024-10-07 Added keyboard interrupt
2024-10-25 First try ESP-IDF
    [Brightness steps.xlsx, partitions.csv]
2024-10-29 Porting to ESP-IDF
    [Porting to ESP-IDF.xlsx, max_app_4MB.csv]
2024-10-31 Convert to ESP-IDF
    [Porting to ESP-IDF.xlsx]
2024-11-01 LVGL attempt
    [Porting to ESP-IDF.xlsx]
2024-11-02 Switched to legacy I²C bus which works better
    [Porting to ESP-IDF.xlsx]
2024-11-03 First working ESP-IDF version
    [Porting to ESP-IDF.xlsx]
2024-11-05 Gradual LED changes implemented
    [Porting to ESP-IDF.xlsx, partitions.csv]
2024-11-05 Random fraction of LED value improved
    [Porting to ESP-IDF.xlsx]
2024-11-06 Improved LED control and added display intensity
    [Porting to ESP-IDF.xlsx]
2024-11-06 LVGL working in Bedclock_IDF_V09
    [Porting to ESP-IDF.xlsx]
2024-11-07 First working version of pixel buffer in Bedclock_IDF_10
    [Porting to ESP-IDF.xlsx]
2024-11-08 Included font in Bedclock_IDF_V11
    [Height and width of many TF fonts.ods]
2024-11-08 Graphical version Bedclock_IDF_V12 working
    [Porting to ESP-IDF.xlsx]
2024-11-11 Extended range of options in move profiles, fixed bug in move animations
    [Click profile.xls, Dynamic movement.ods, Profile definitions V2.ods, Spring profile.xls]
2024-11-13 Show/remove clock when light switched on/off
2024-11-13 V1.2.0: Left and right buttons resets the device
    [bl_keyboard.h, main.c]
2024-11-14 Mapped LED colors on color temperature
    [Porting to ESP-IDF.xlsx]
2024-11-14 Update buttons
